timembedded/hyper-fusion-xc/board/3dmodels/WQFN-30-2.5x4.5-p0.4.step

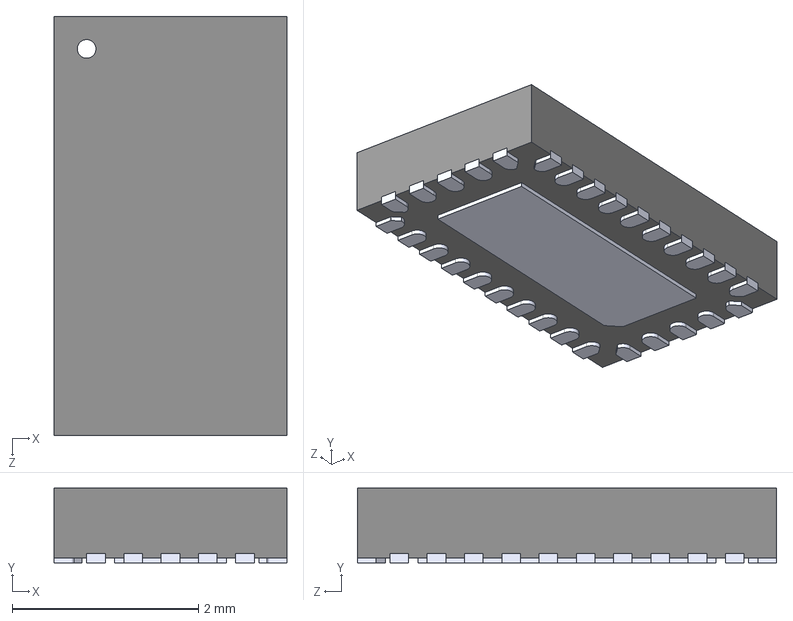
[picture p1: CAD file, 2026-04-17]
board/3dmodels/WQFN-30-2.5x4.5-p0.4.step
2.50 x 0.8 x 4.50 mm
