timembedded/hyper-fusion-xc/board/HyperFusionXC.FCStd

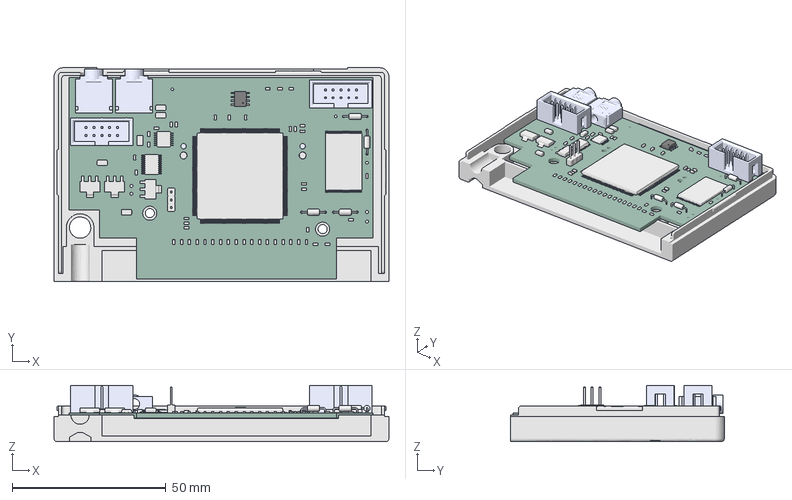
[picture p2: CAD file, 2025-03-14]
board/HyperFusionXC.FCStd
109.0 x 69.5 x 18.3 mm
PinHeader_1x03_P254mm_Vertical
R_0603_1608Metric
R_0603_1608Metric002
R_0603_1608Metric004
D_DO-35_SOD27_P7.62mm_Horizontal
D_DO-35_SOD27_P7.62mm_Horizontal001
R_0603_1608Metric006
C_0603_1608Metric
CP_EIA_3216_10_Kemet_I
R_0603_1608Metric008
R_0603_1608Metric010
R_0603_1608Metric012
R_0603_1608Metric014
CP_EIA_3216_10_Kemet_I001
C_0603_1608Metric002
R_0603_1608Metric016
C_0603_1608Metric004
R_0603_1608Metric018
CP_EIA_3216_10_Kemet_I002
SOT_223
C_0603_1608Metric006
CP_EIA_3216_10_Kemet_I003
LED_0603_1608Metric
C_0603_1608Metric008
TSOP_I_48_184x12mm_P05mm
SOT_224
R_0603_1608Metric020
TSSOP_20_44x65mm_P065mm
R_0603_1608Metric022
R_0603_1608Metric024
R_0603_1608Metric026
R_0603_1608Metric028
R_0603_1608Metric030
C_0603_1608Metric010
R_0603_1608Metric032
R_0603_1608Metric034
CQ assembly
CQ assembly001
CQ assembly002
CQ assembly003
CQ assembly004
CQ assembly005
CQ assembly006
CQ assembly007
CQ assembly008
CQ assembly009
C_0603_1608Metric012
R_0603_1608Metric036
D_DO-35_SOD27_P7.62mm_Horizontal004
D_DO-35_SOD27_P7.62mm_Horizontal005
C_0603_1608Metric014
D_DO-35_SOD27_P7.62mm_Horizontal008
D_DO-35_SOD27_P7.62mm_Horizontal009
TSSOP_14_44x5mm_P065mm
C_0603_1608Metric016
C_0603_1608Metric018
CUI_DEVICES_SJ1-3525N
C_0603_1608Metric020
C_0603_1608Metric022
R_0603_1608Metric038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
