timembedded/hyper-fusion-xc/board/3dmodels/AP7366EA-18W5-7.stp

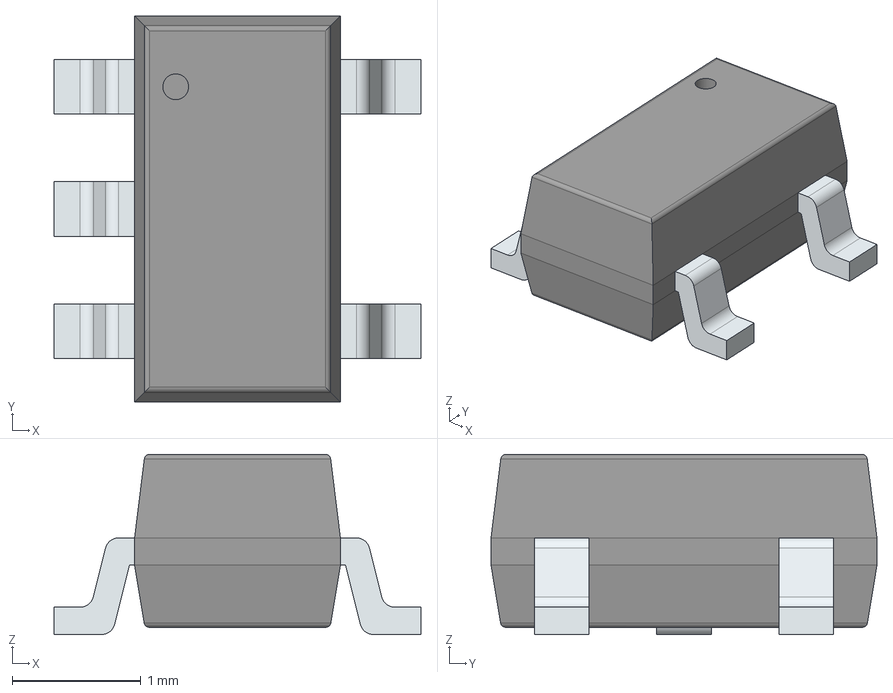
[picture p3: CAD file, 2026-03-26]
board/3dmodels/AP7366EA-18W5-7.stp
2.85 x 3.00 x 1.40 mm
PinsArrayL
PinsArrayR
