timembedded/hyper-fusion-xc/board/3dmodels/DLM0NSN900HY2D.step

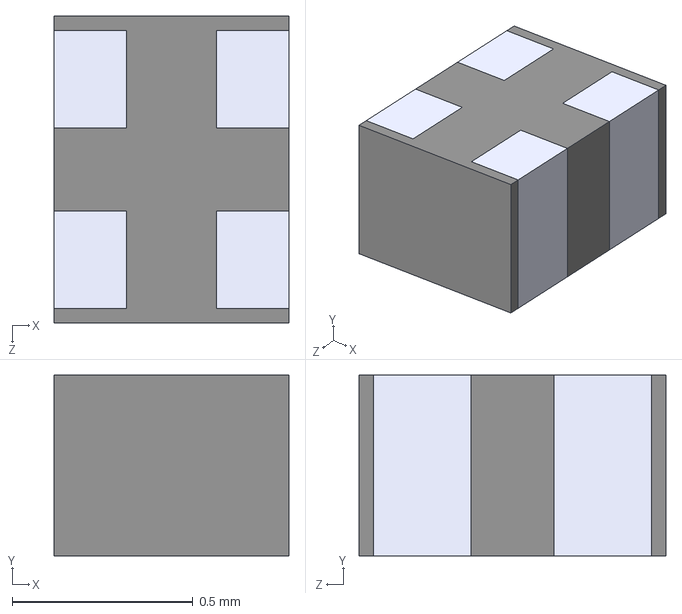
[picture p4: CAD file, 2026-02-20]
board/3dmodels/DLM0NSN900HY2D.step
0.65 x 0.5 x 0.85 mm
