timembedded/hyper-fusion-xc/board/3dmodels/NAU88C22YG.step

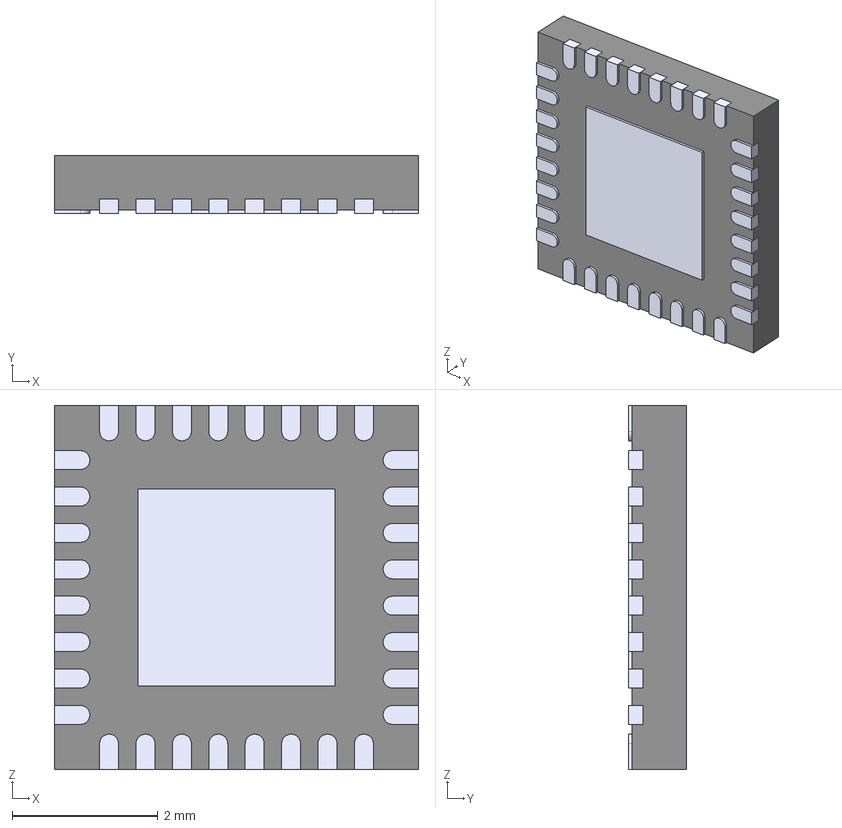
[picture p5: CAD file, 2026-02-02]
board/3dmodels/NAU88C22YG.step
5.00 x 0.8 x 5.00 mm
Body_Solid1
Body001_Solid1
Array_Solid1 x 8
Array001_Solid2 x 7
Body002_Solid1
Array002_Solid1 x 8
Array003_Solid2 x 7
Body003_Solid1
Body004_Solid1
