timembedded/hyper-fusion-xc/board/3dmodels/UJ20-C-H-G-SMT-2-P16-TR.step

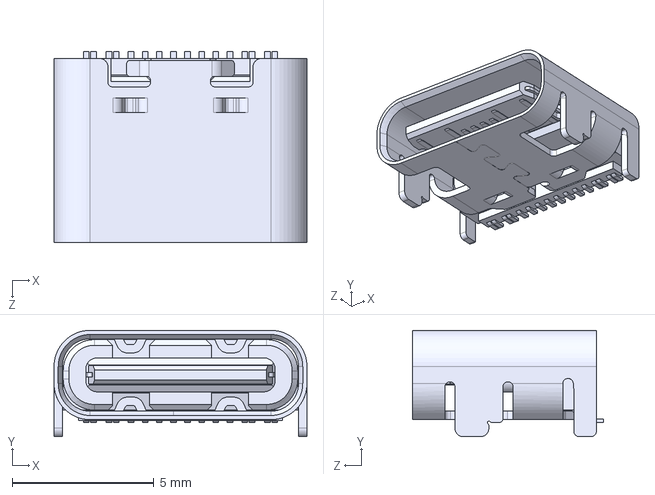
[picture p6: CAD file, 2026-02-02]
board/3dmodels/UJ20-C-H-G-SMT-2-P16-TR.step
8.94 x 3.76 x 6.75 mm
