timembedded/hyper-fusion-xc/board/3dmodels/ESP32-C3-WROOM-02-N4.step

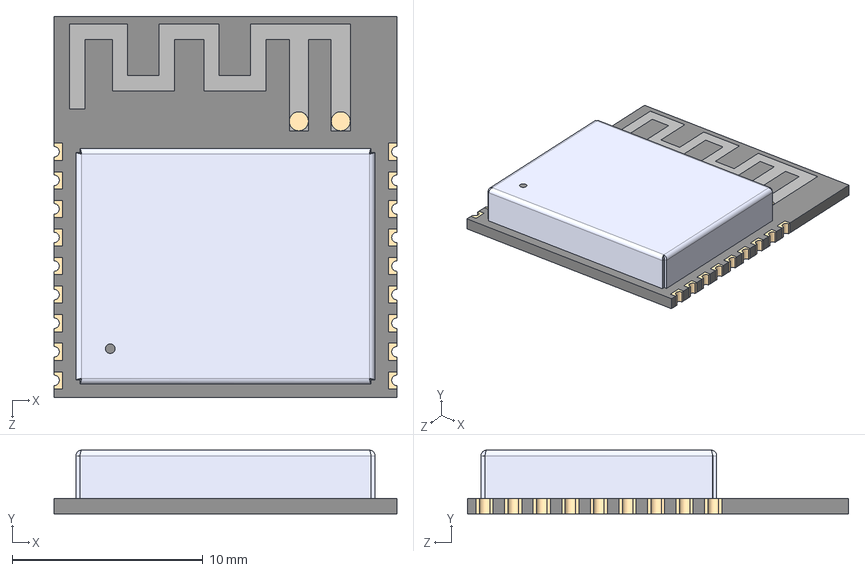
[picture p7: CAD file, 2025-11-15]
board/3dmodels/ESP32-C3-WROOM-02-N4.step
18.0 x 3.35 x 20.0 mm
