timembedded/hyper-fusion-xc/board/3dmodels/SJ-3524-SMT-TR.STEP

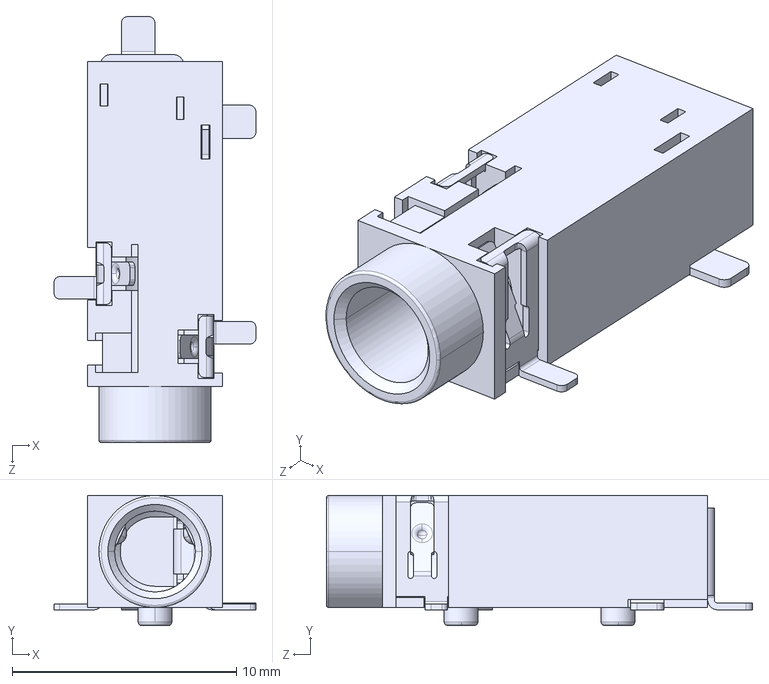
[picture p8: CAD file, 2025-11-15]
board/3dmodels/SJ-3524-SMT-TR.STEP
9.00 x 5.80 x 19.0 mm
