timembedded/hyper-fusion-xc/board/3dmodels/EVQ-P7A01P.step

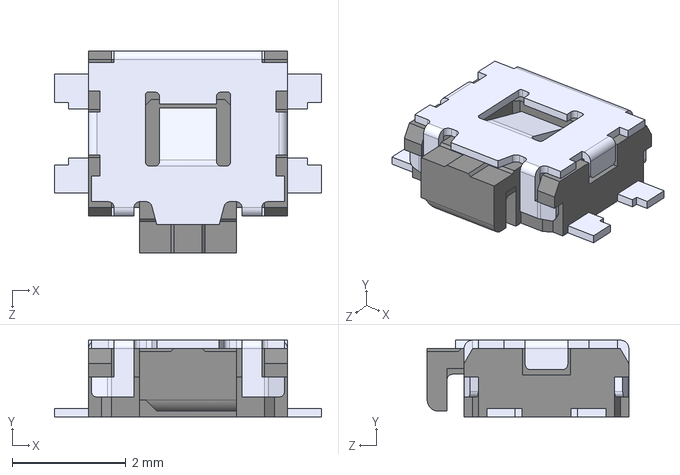
[picture p9: CAD file, 2025-11-15]
board/3dmodels/EVQ-P7A01P.step
4.70 x 1.35 x 3.55 mm
