timembedded/hyper-fusion-xc/board/3dmodels/WNCB-2100037.stp

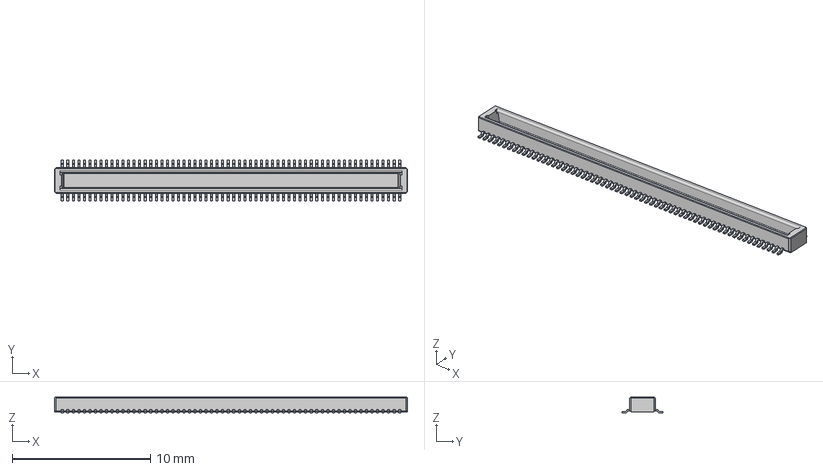
[picture p10: CAD file, 2025-11-15]
board/3dmodels/WNCB-2100037.stp
25.5 x 2.97 x 1.14 mm
