timembedded/hyper-fusion-xc/board/3dmodels/QFP50P700X700X120-32N.step

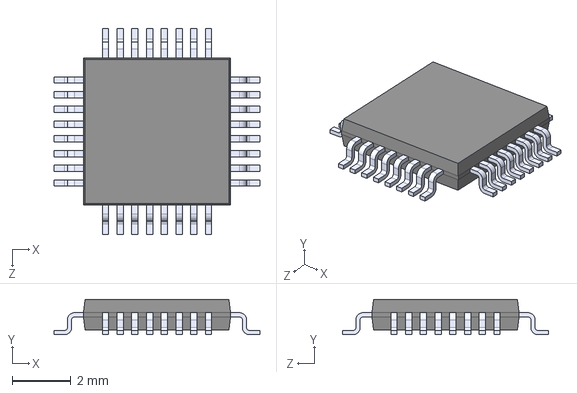
[picture p11: CAD file, 2025-11-15]
board/3dmodels/QFP50P700X700X120-32N.step
7.00 x 1.20 x 7.00 mm
