timembedded/hyper-fusion-xc/board/3dmodels/SS-53000-001.step

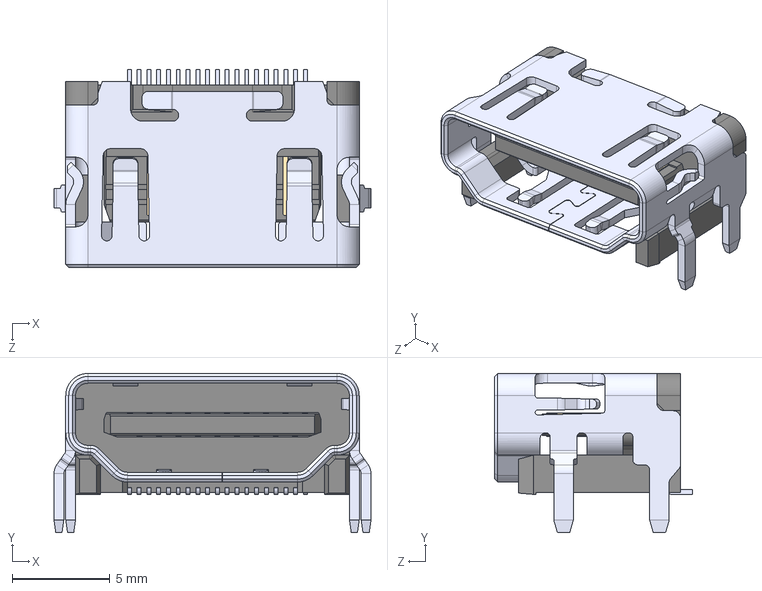
[picture p12: CAD file, 2025-11-15]
board/3dmodels/SS-53000-001.step
16.2 x 8.13 x 10.1 mm
