timembedded/hyper-fusion-xc/board/3dmodels/PTS526SM20SMTR21_LFS.stp

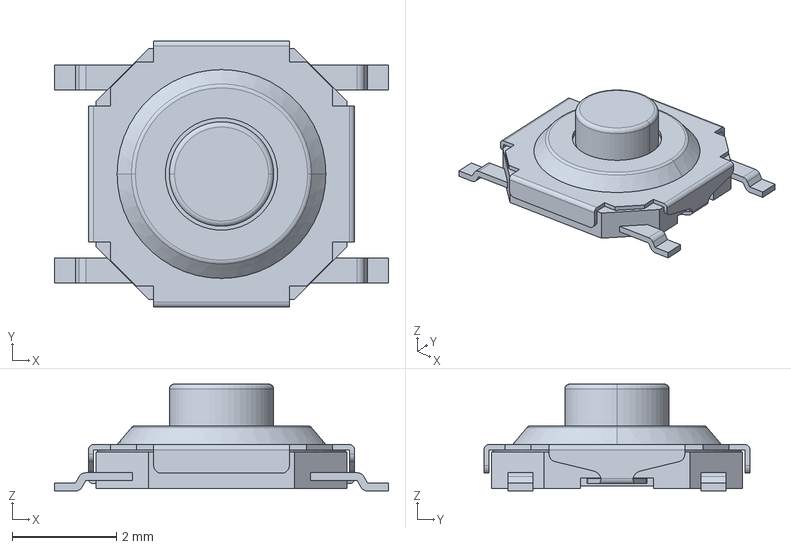
[picture p13: CAD file, 2025-11-15]
board/3dmodels/PTS526SM20SMTR21_LFS.stp
6.40 x 5.10 x 2.05 mm
