timembedded/hyper-fusion-xc/board/3dmodels/TL3336AF160Q.STEP

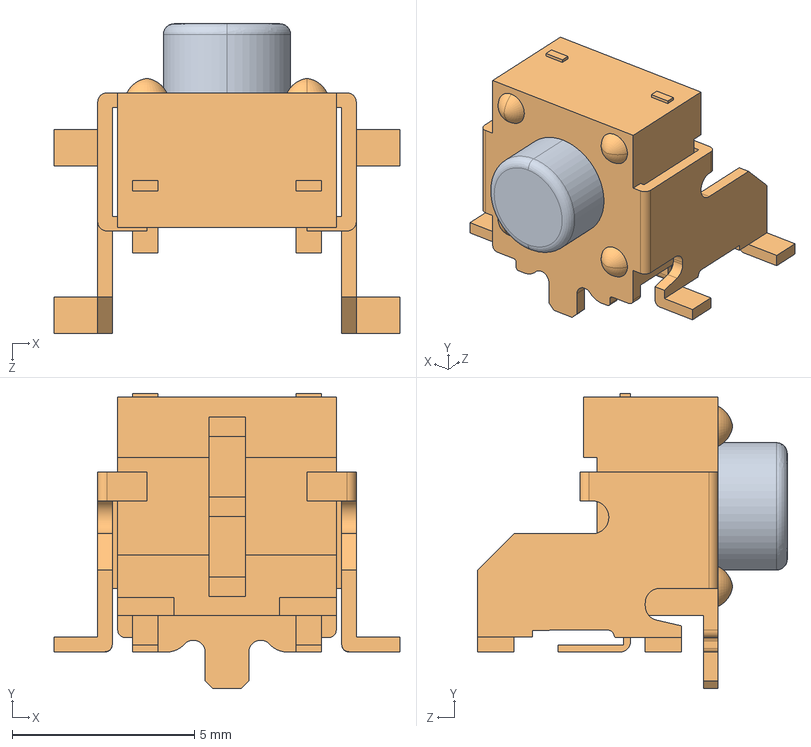
[picture p14: CAD file, 2025-11-15]
board/3dmodels/TL3336AF160Q.STEP
9.50 x 8.10 x 8.50 mm
