timembedded/hyper-fusion-xc/board/3dmodels/CUI_DEVICES_SJ1-3525N.step

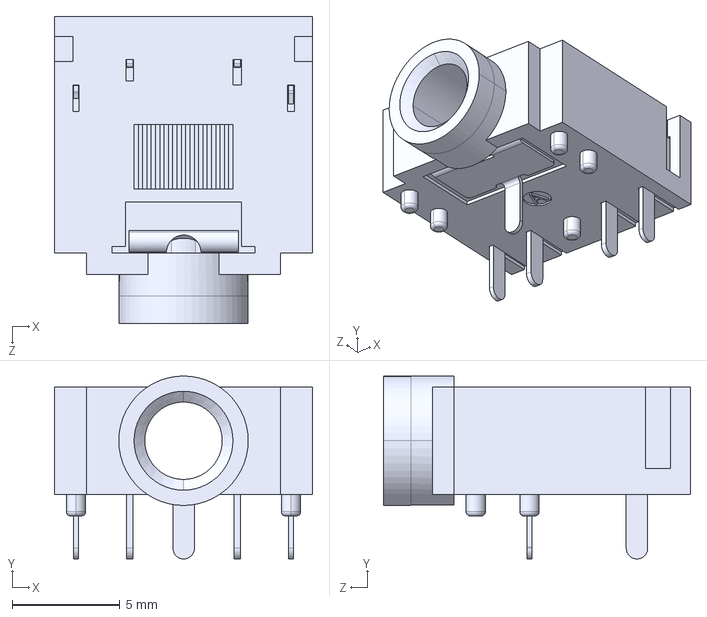
[picture p15: CAD file, 2025-11-15]
board/3dmodels/CUI_DEVICES_SJ1-3525N.step
12.0 x 8.51 x 14.3 mm
