timembedded/hyper-fusion-xc/board/3dmodels/ESP32-S3-WROOM-1-N8R8.STEP

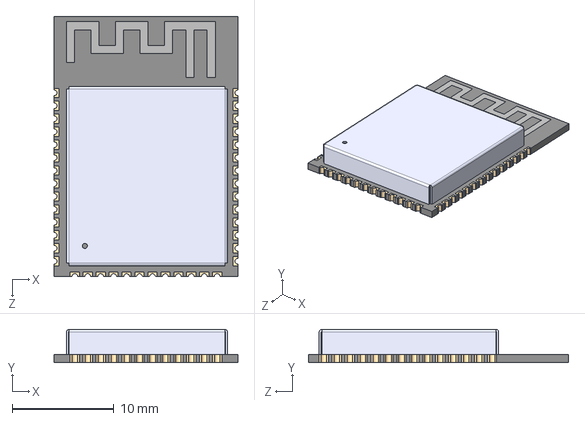
[picture p16: CAD file, 2025-11-15]
board/3dmodels/ESP32-S3-WROOM-1-N8R8.STEP
18.0 x 3.25 x 25.5 mm
