timembedded/hyper-fusion-xc/board/3dmodels/CS1102V6.85F100.stp

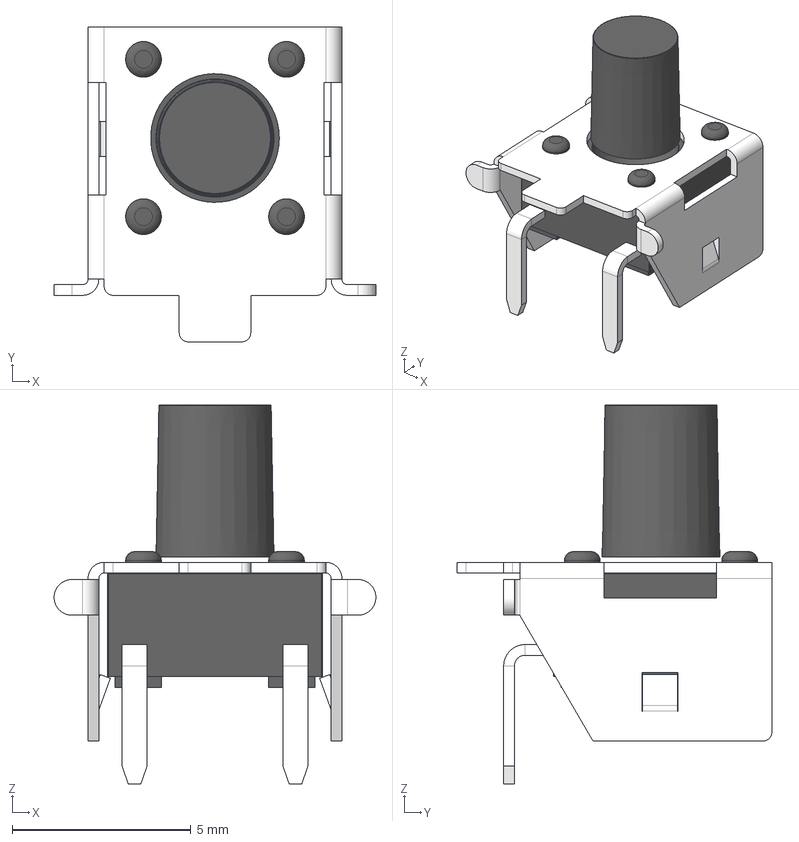
[picture p17: CAD file, 2025-11-15]
board/3dmodels/CS1102V6.85F100.stp
9.00 x 8.80 x 10.6 mm
Base_New
Frame_CS
Terminal x 2
Actuator taper6.85
