timembedded/hyper-fusion-xc/board/3dmodels/2086581201.stp

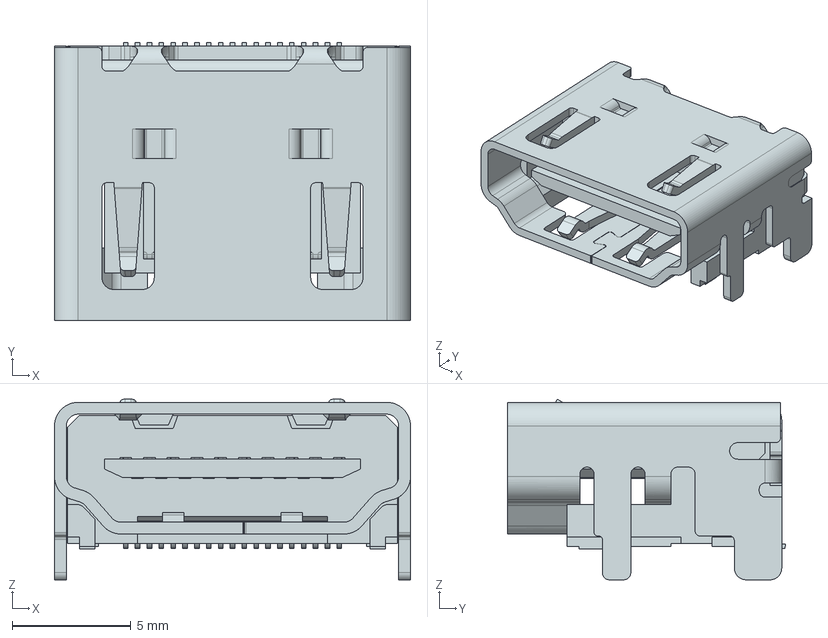
[picture p18: CAD file, 2025-11-15]
board/3dmodels/2086581201.stp
15.0 x 11.7 x 7.61 mm
