timembedded/hyper-fusion-xc/(list of files, cad)

Other CAD files:
board/3dmodels/10029449-111RLF.STEP
board/3dmodels/10067847-001RLF.step
board/3dmodels/467650301.stp
board/3dmodels/9774015151R_20_28rev1_29.stp
