timembedded/hyper-fusion-xc/(list of files, drawings)

Other design files:
board/HyperFusionXC.pcb
