timembedded/hyper-fusion-xc/board/HyperFusionXC.kicad_pcb

## KiCad design board/HyperFusionXC.kicad_pcb (2026-04-17)

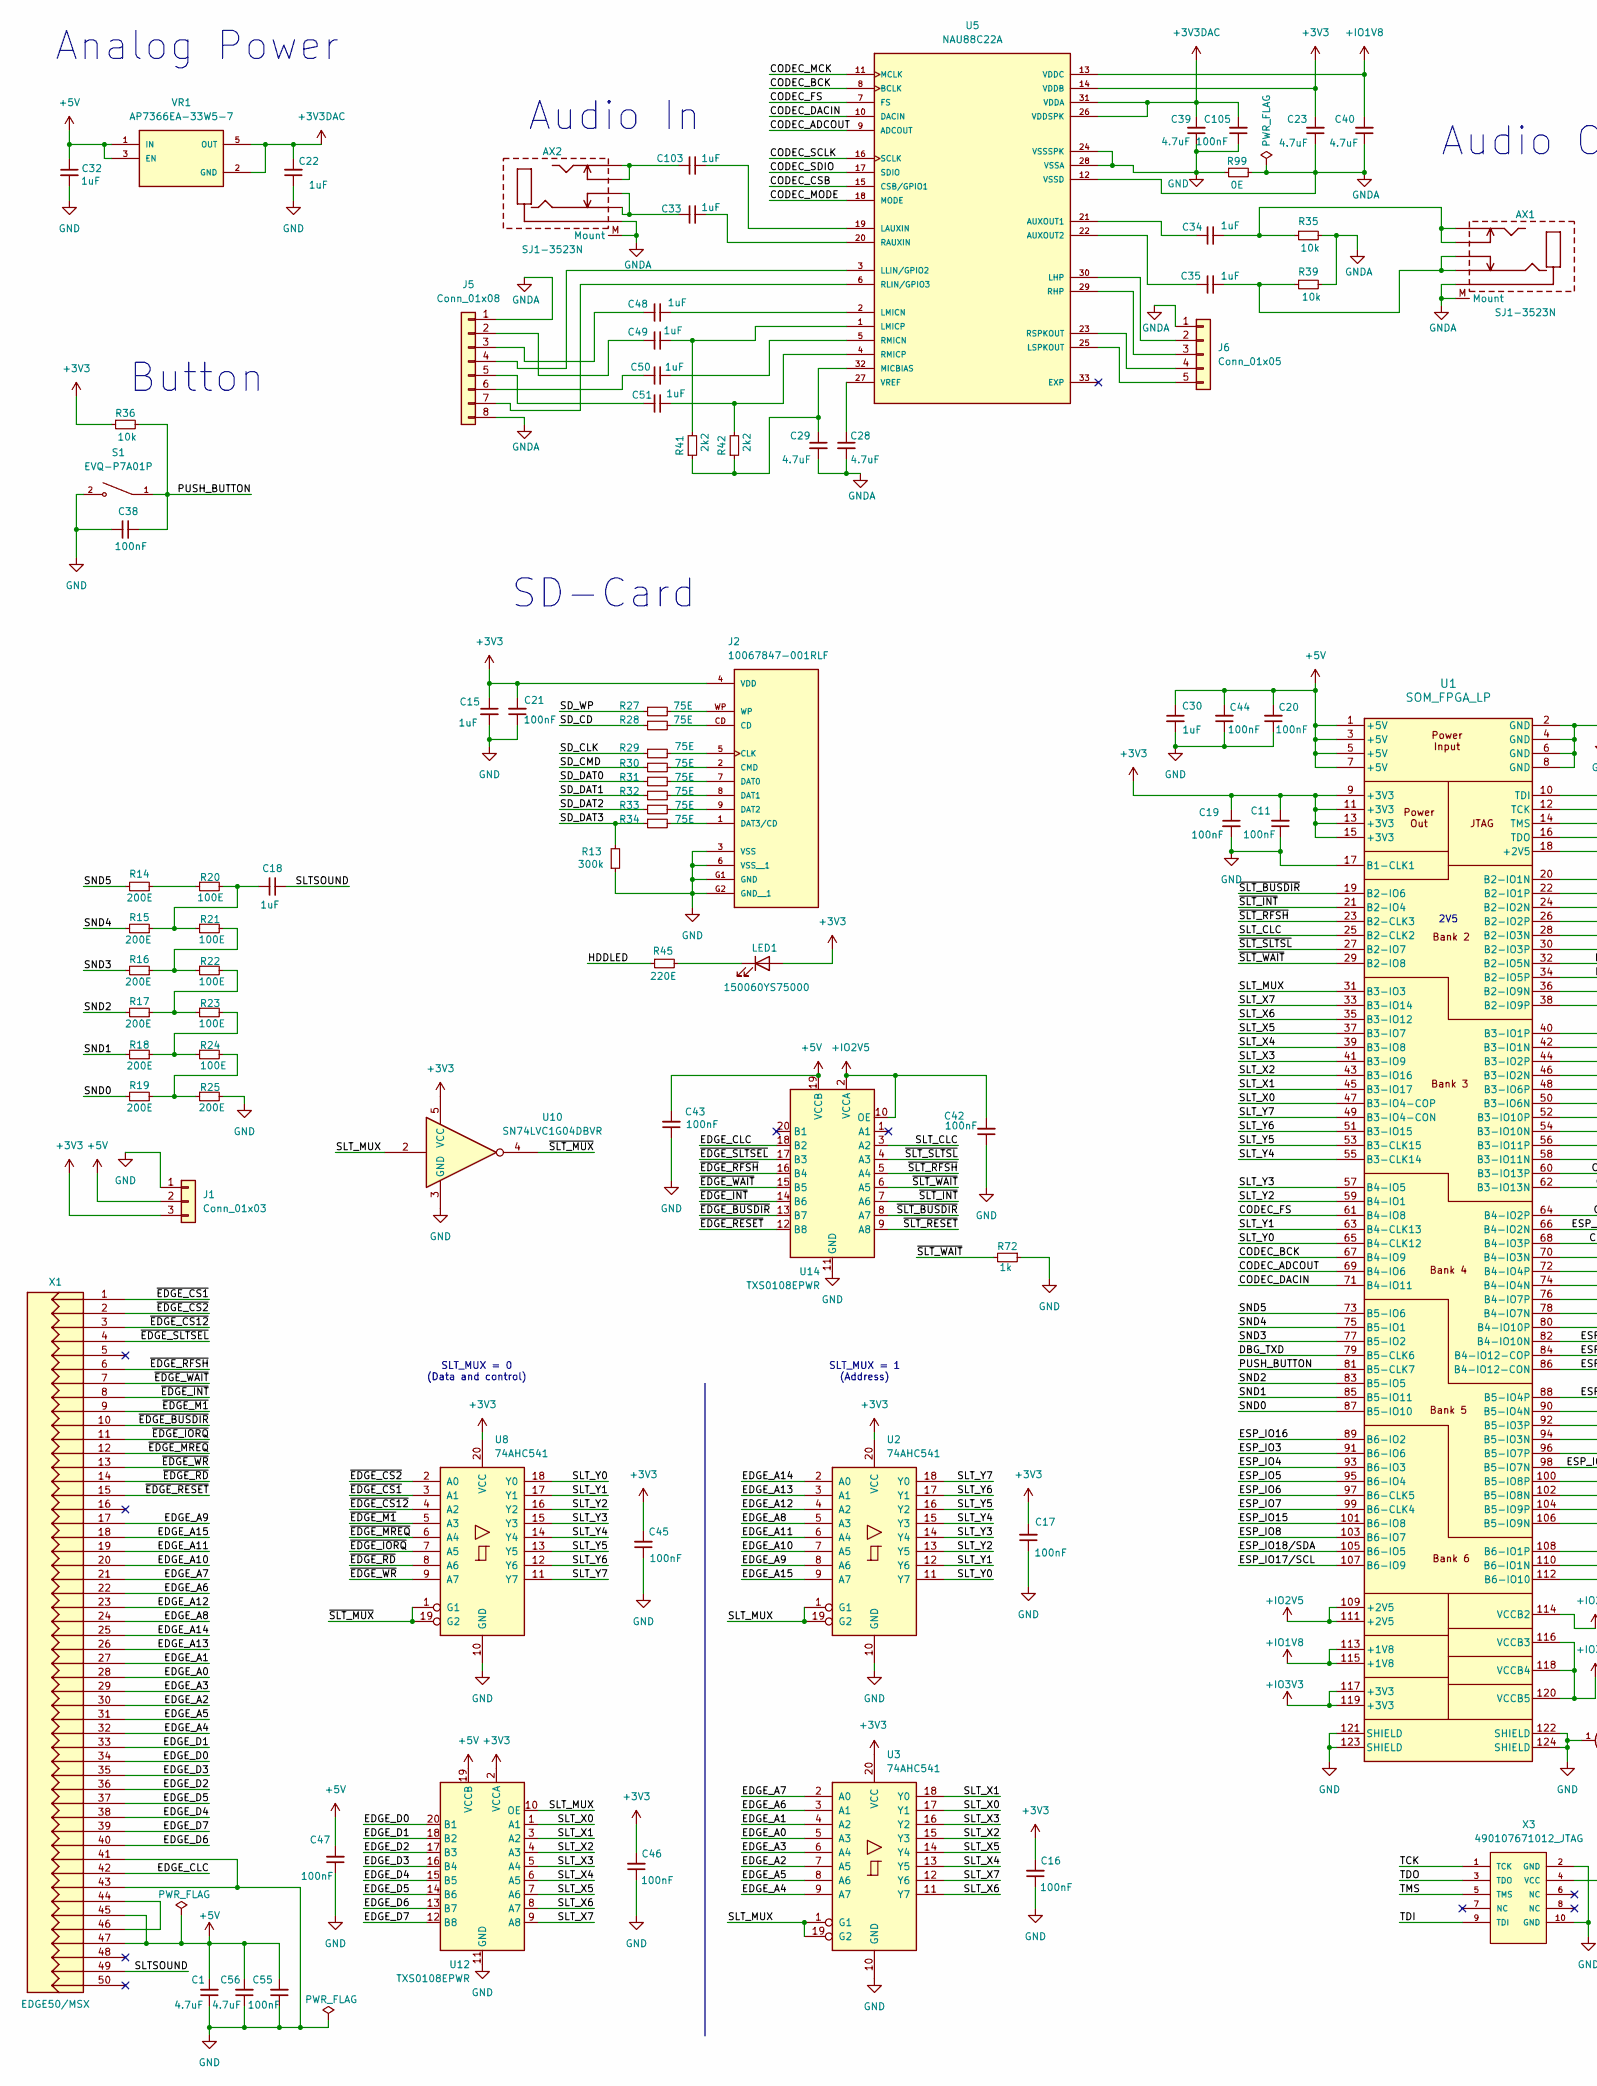
[picture p19: schematic HyperFusionXC.kicad_sch, FusionXC, part in row 1, column 1]

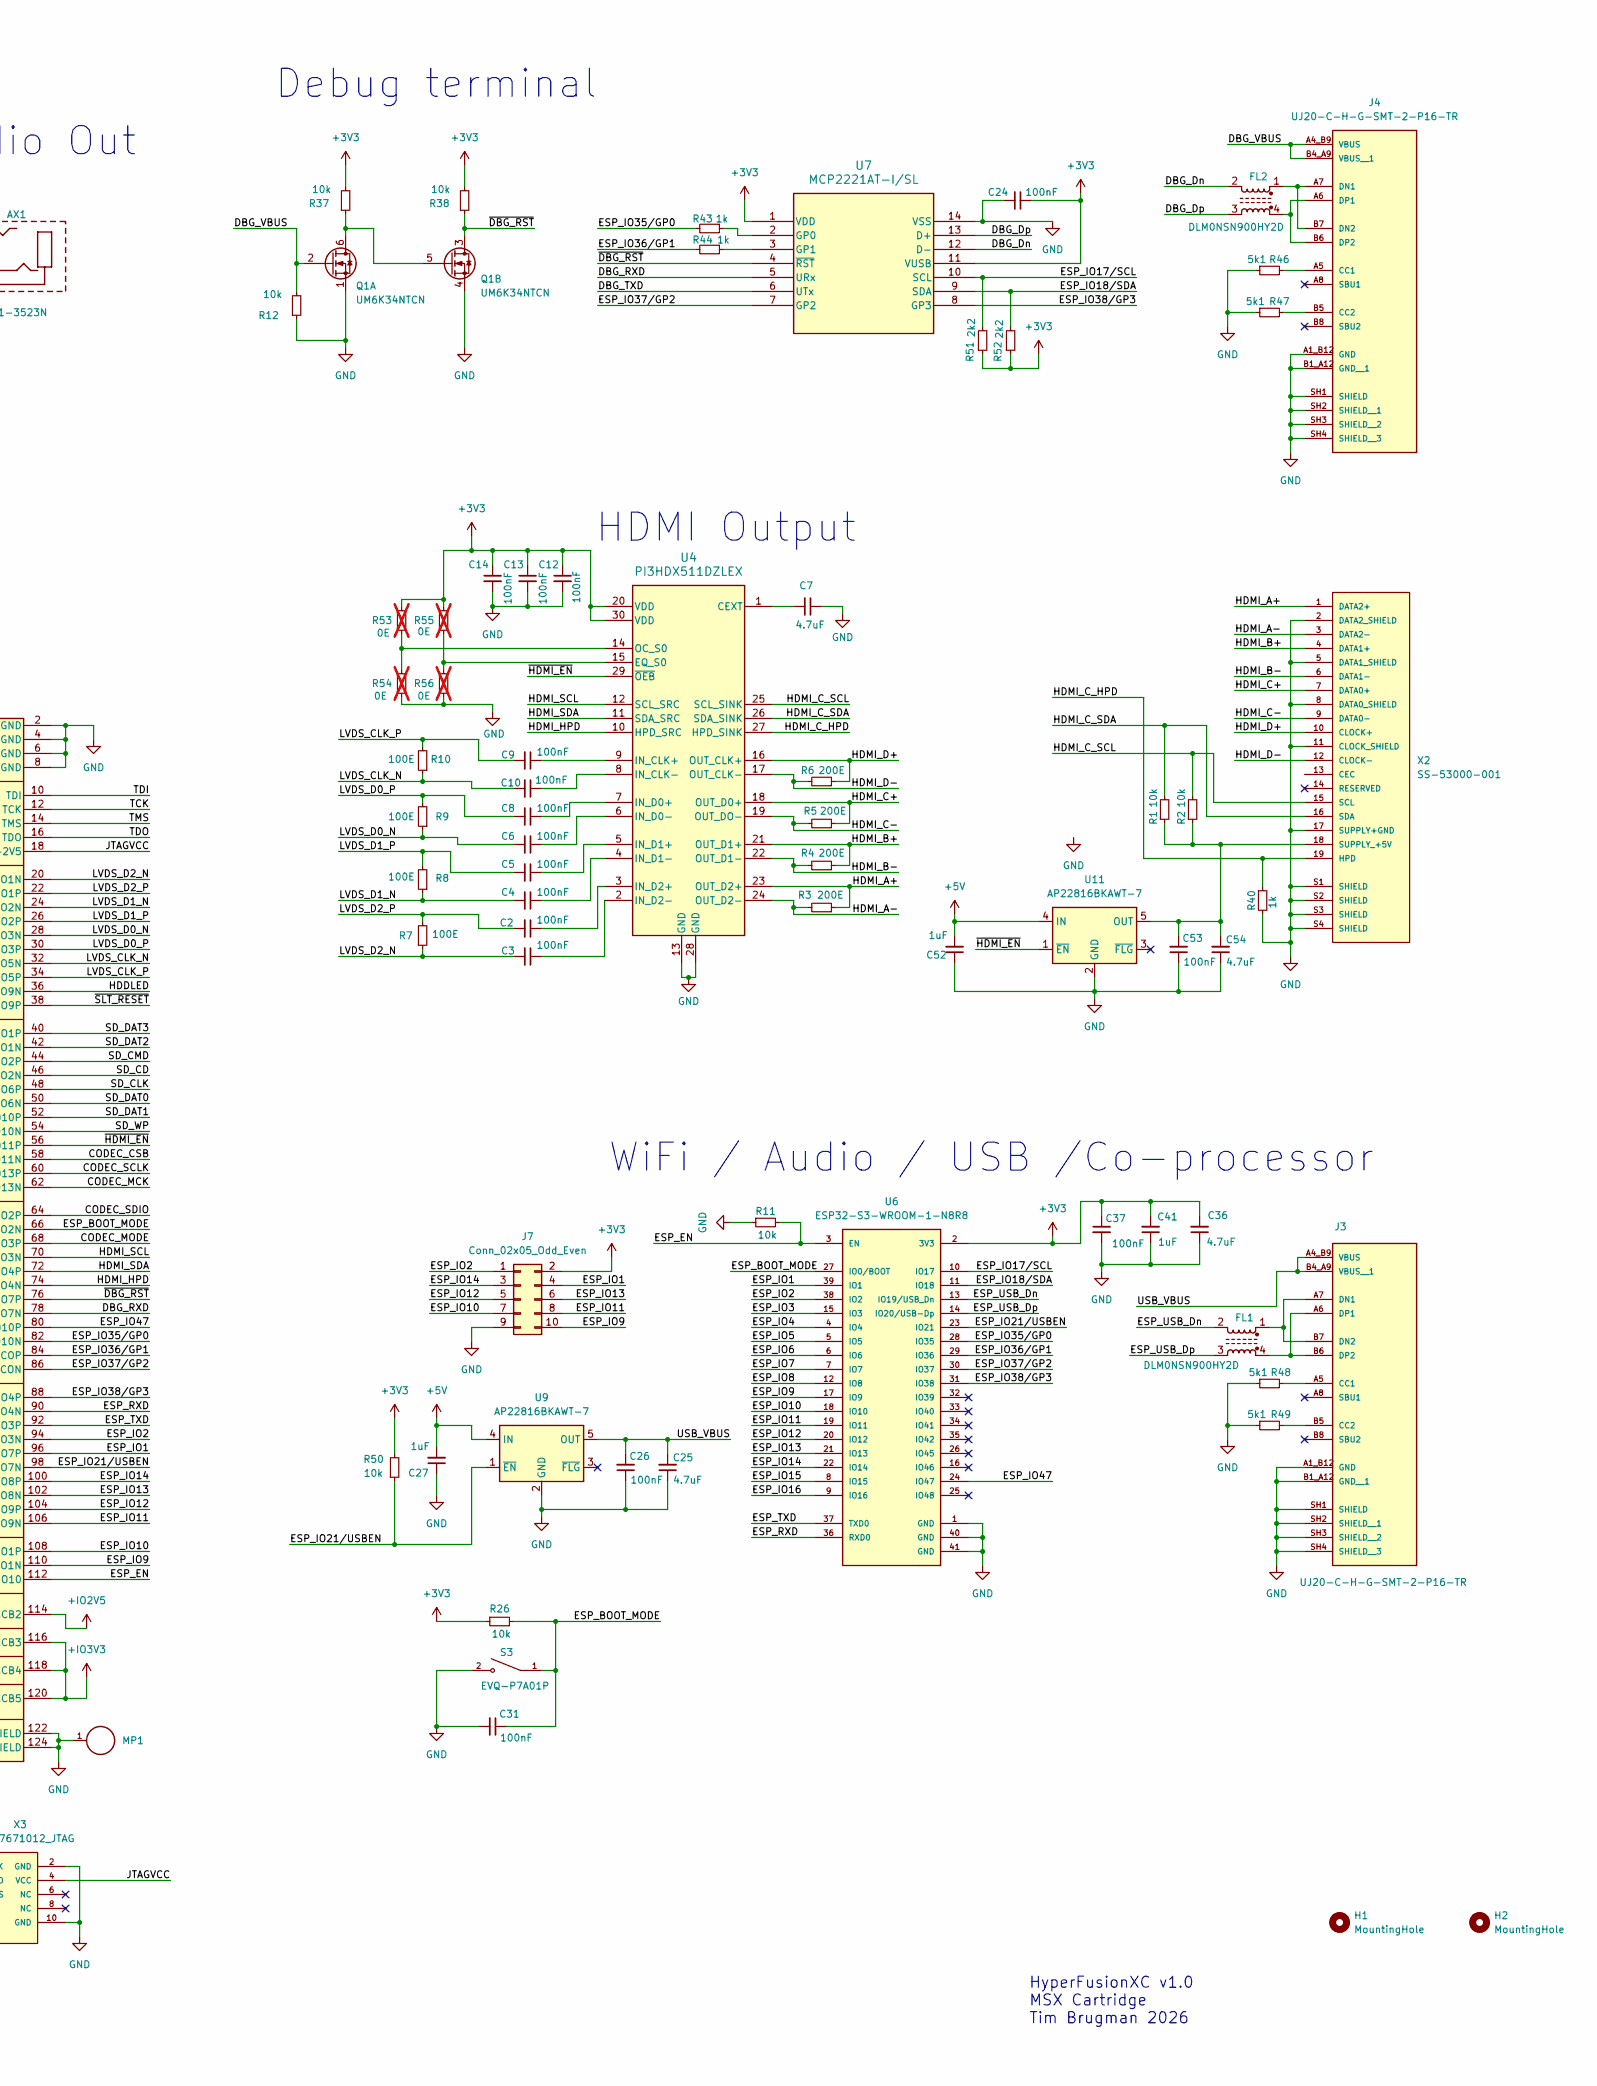
[picture p20: schematic HyperFusionXC.kicad_sch, FusionXC, part in row 1, column 2]

Parts:
AX1, AX2: SJ1-3523N; ST-222_1; DIGIKEY CP1-3523N-ND
C1, C7, C23, C25, C28, C29, C36, C39, C40, C54, C56: 4.7uF; C_0603_1608Metric; DIGIKEY 1276-2087-1-ND
C2, C3, C4, C5, C6, C8, C9, C10, C11, C12, C13, C14, C16, C17, C19, C20, C21, C24, C26, C31, C37, C38, C42, C43, C44, C45, C46, C47, C53, C55, C105: 100nF; C_0603_1608Metric; DIGIKEY 311-1088-1-ND
C15, C18, C22, C27, C30, C32, C33, C34, C35, C41, C48, C49, C50, C51, C52, C103: 1uF; C_0603_1608Metric; DIGIKEY 4988-NMC0603X7R105K6.3TRPFCT-ND
FL1, FL2: DLM0NSN900HY2D; FIL_DLM0NSN900HY2D; DIGIKEY 490-DLM0NSN900HY2DCT-ND
H1, H2: MountingHole
J1: Conn_01x03; PinHeader_1x03_P2.54mm_Vertical
J2: 10067847-001RLF; AMPHENOL_10067847-001RLF; PARTREV K; DIGIKEY 609-3956-1-ND
J3, J4: UJ20-C-H-G-SMT-2-P16-TR; SAMESKY_UJ20-C-H-G-SMT-2-P16-TR; PARTREV 1.0; DIGIKEY 2223-UJ20-C-H-G-SMT-2A-P16-TRCT-ND
J5: Conn_01x08; PinHeader_1x08_P2.00mm_Vertical
J6: Conn_01x05; PinSocket_1x05_P2.00mm_Vertical
J7: Conn_02x05_Odd_Even; PinHeader_2x05_P2.00mm_Vertical
LED1: 150060YS75000; LED_0603_1608Metric_Pad1.05x0.95mm_HandSolder; DIGIKEY 732-4981-1-ND
MP1: M2.5 x 1.5mm; WA-SMSI_9774015151; PART-NUMBER 9774015151R; DIGIKEY 732-7068-1-ND
Q1: UM6K34NTCN; SOT-363_SC-70-6; DIGIKEY UM6K34NTCNCT-ND
R1, R2, R11, R12, R26, R35, R36, R37, R38, R39, R50: 10k; R_0603_1608Metric; DIGIKEY RMCF0603FT10K0CT-ND
R3, R4, R5, R6, R14, R15, R16, R17, R18, R19, R25: 200E; R_0603_1608Metric; DIGIKEY 4463-TFAS0603R2000F-T5CT-ND
R7, R8, R9, R10, R20, R21, R22, R23, R24: 100E; R_0603_1608Metric; DIGIKEY 4463-TFAS0603R1000F-T5CT-ND
R13: 300k; R_0603_1608Metric; DIGIKEY RMCF0603FT300KCT-ND
R27, R28, R29, R30, R31, R32, R33, R34: 75E; R_0603_1608Metric; DIGIKEY RMCF0603FT75R0CT-ND
R40, R43, R44, R72: 1k; R_0603_1608Metric; DIGIKEY RMCF0603FT1K00CT-ND
R41, R42, R51, R52: 2k2; R_0603_1608Metric; DIGIKEY RMCF0603FT2K20CT-ND
R45: 220E; R_0603_1608Metric; DIGIKEY RMCF0603FT220RCT-ND
R46, R47, R48, R49: 5k1; R_0603_1608Metric; DIGIKEY RMCF0603FT5K10CT-ND
R53, R54, R55, R56: 0E; R_0603_1608Metric; DIGIKEY RMCF0603ZT0R00CT-ND; not fitted
R99: 0E; SolderJumper-2_P1.3mm_Bridged_Pad1.0x1.5mm
S1, S3: EVQ-P7A01P; SW_EVQ-P7A01P; PARTREV 2022.4; DIGIKEY P16763CT-ND
U1: SOM_FPGA_LP; DIGIKEY 26-DF40C-120DP-0.4V(51)CT-ND
U2, U3, U8: 74AHC541; TSSOP-20_4.4x6.5mm_P0.65mm; DIGIKEY 1727-3994-1-ND
U4: PI3HDX511DZLEX; Texas_RNH0030A_WQFN-30-1EP_2.5x4.5mm_P0.4mm_EP1.2x3.2mm; DIGIKEY PI3HDX511DZLEXDICT-ND
U5: NAU88C22A; QFN-32-1EP_5x5mm_P0.5mm_EP2.7x2.7mm_ThermalVias; PARTREV 3.3; DIGIKEY NAU88C22YG-ND
U6: ESP32-S3-WROOM-1-N8R8; MODULE_ESP32-S3-WROOM-1-N8R8; DIGIKEY 5407-ESP32-S3-WROOM-1-N8R8CT-ND
U7: MCP2221AT-I/SL; SOIC-14_3.9x8.7mm_P1.27mm; DIGIKEY 150-MCP2221AT-I/SLCT-ND
U9, U11: AP22816BKAWT-7; SOT-23-5; DIGIKEY 31-AP22816BKAWT-7CT-ND
U10: SN74LVC1G04DBVR; SOT-23-5; DIGIKEY 296-11599-1-ND
U12, U14: TXS0108EPWR; TSSOP-20_4.4x6.5mm_P0.65mm; DIGIKEY 296-23011-1-ND
VR1: AP7366EA-33W5-7; SOT-25-AP7366EA; PARTREV 1-2; DIGIKEY 31-AP7366EA-33W5-7CT-ND
X1: EDGE50/MSX; EDGE50_MSX_1
X2: SS-53000-001; STEWART_SS-53000-001; PARTREV A0; DIGIKEY 380-SS-53000-001-ND
X3: 490107671012_JTAG; 490107671012; PARTREV A0; DIGIKEY 732-11636-5-ND

Connections:
+3V3: C11.2, C12.1, C13.1, C14.1, C15.1, C16.2, C17.2, C19.1, C21.2, C23.2, C24.2, C36.2, C37.1, C41.2, C45.2, C46.2, J1.3, J2.4 (VDD), J7.2, LED1.2 (A), R26.1, R36.1, R37.2, R38.2, R50.2, R51.1, R52.1, R53.1, R55.1, U1.9 (+3V3), U1.11 (+3V3), U1.13 (+3V3), U1.15 (+3V3), U2.20 (VCC), U3.20 (VCC), U4.20 (VDD), U4.30 (VDD), U5.14 (VDDB), U6.2 (3V3), U7.1 (VDD), U7.11 (VUSB), U8.20 (VCC), U10.5 (VCC), U12.2 (VCCA)
+3V3DAC: C22.2, C39.2, C105.2, U5.26 (VDDSPK), U5.31 (VDDA), VR1.2 (GND), VR1.5 (OUT)
+5V: C1.2, C20.2, C27.2, C30.1, C32.1, C43.2, C44.2, C47.2, C52.2, C55.2, C56.2, J1.2, U1.1 (+5V), U1.3 (+5V), U1.5 (+5V), U1.7 (+5V), U9.4 (IN), U11.4 (IN), U12.19 (VCCB), U14.19 (VCCB), VR1.1 (IN), VR1.3 (EN), X1.45, X1.47
+IO1V8: C40.2, U1.113 (+1V8), U1.115 (+1V8), U5.13 (VDDC)
+IO2V5: C42.2, U1.109 (+2V5), U1.111 (+2V5), U1.114 (VCCB2), U14.2 (VCCA), U14.10 (OE)
+IO3V3: U1.116 (VCCB3), U1.117 (+3V3), U1.118 (VCCB4), U1.119 (+3V3), U1.120 (VCCB5)
/CODEC_ADCOUT: U1.69 (B4-IO6), U5.9 (ADCOUT)
/CODEC_BCK: U1.67 (B4-IO9), U5.8 (BCLK)
/CODEC_CSB: U1.58 (B3-IO11N), U5.15 (CSB/GPIO1)
/CODEC_DACIN: U1.71 (B4-IO11), U5.10 (DACIN)
/CODEC_FS: U1.61 (B4-IO8), U5.7 (FS)
/CODEC_MCK: U1.62 (B3-IO13N), U5.11 (MCLK)
/CODEC_MODE: U1.68 (B4-IO3P), U5.18 (MODE)
/CODEC_SCLK: U1.60 (B3-IO13P), U5.16 (SCLK)
/CODEC_SDIO: U1.64 (B4-IO2P), U5.17 (SDIO)
/DBG_Dn: FL2.2, U7.12 (D-)
/DBG_Dp: FL2.3, U7.13 (D+)
/DBG_RXD: U1.78 (B4-IO7N), U7.5 (URx)
/DBG_TXD: U1.79 (B5-CLK6), U7.6 (UTx)
/DBG_VBUS: J4.A4_B9 (VBUS), J4.B4_A9 (VBUS__1), Q1.2 (G), R12.2
/EDGE_A0: U3.5 (A3), X1.28
/EDGE_A1: U3.4 (A2), X1.27
/EDGE_A2: U3.7 (A5), X1.30
/EDGE_A3: U3.6 (A4), X1.29
/EDGE_A4: U3.9 (A7), X1.32
/EDGE_A5: U3.8 (A6), X1.31
/EDGE_A6: U3.3 (A1), X1.22
/EDGE_A7: U3.2 (A0), X1.21
/EDGE_A8: U2.5 (A3), X1.24
/EDGE_A9: U2.8 (A6), X1.17
/EDGE_A10: U2.7 (A5), X1.20
/EDGE_A11: U2.6 (A4), X1.19
/EDGE_A12: U2.4 (A2), X1.23
/EDGE_A13: U2.3 (A1), X1.26
/EDGE_A14: U2.2 (A0), X1.25
/EDGE_A15: U2.9 (A7), X1.18
/EDGE_CLC: U14.18 (B2), X1.42
/EDGE_D0: U12.20 (B1), X1.34
/EDGE_D1: U12.18 (B2), X1.33
/EDGE_D2: U12.17 (B3), X1.36
/EDGE_D3: U12.16 (B4), X1.35
/EDGE_D4: U12.15 (B5), X1.38
/EDGE_D5: U12.14 (B6), X1.37
/EDGE_D6: U12.13 (B7), X1.40
/EDGE_D7: U12.12 (B8), X1.39
/ESP_BOOT_MODE: C31.1, R26.2, S3.1, U1.66 (B4-IO2N), U6.27 (IO0/BOOT)
/ESP_EN: R11.2, U1.112 (B6-IO10), U6.3 (EN)
/ESP_IO1: J7.4, U1.96 (B5-IO7P), U6.39 (IO1)
/ESP_IO2: J7.1, U1.94 (B5-IO3N), U6.38 (IO2)
/ESP_IO3: U1.91 (B6-IO6), U6.15 (IO3)
/ESP_IO4: U1.93 (B6-IO3), U6.4 (IO4)
/ESP_IO5: U1.95 (B6-IO4), U6.5 (IO5)
/ESP_IO6: U1.97 (B6-CLK5), U6.6 (IO6)
/ESP_IO7: U1.99 (B6-CLK4), U6.7 (IO7)
/ESP_IO8: U1.103 (B6-IO7), U6.12 (IO8)
/ESP_IO9: J7.10, U1.110 (B6-IO1N), U6.17 (IO9)
/ESP_IO10: J7.7, U1.108 (B6-IO1P), U6.18 (IO10)
/ESP_IO11: J7.8, U1.106 (B5-IO9N), U6.19 (IO11)
/ESP_IO12: J7.5, U1.104 (B5-IO9P), U6.20 (IO12)
/ESP_IO13: J7.6, U1.102 (B5-IO8N), U6.21 (IO13)
/ESP_IO14: J7.3, U1.100 (B5-IO8P), U6.22 (IO14)
/ESP_IO15: U1.101 (B6-IO8), U6.8 (IO15)
/ESP_IO16: U1.89 (B6-IO2), U6.9 (IO16)
/ESP_IO17/SCL: R51.2, U1.107 (B6-IO9), U6.10 (IO17), U7.10 (SCL)
/ESP_IO18/SDA: R52.2, U1.105 (B6-IO5), U6.11 (IO18), U7.9 (SDA)
/ESP_IO21/USBEN: R50.1, U1.98 (B5-IO7N), U6.23 (IO21), U9.1 (~EN)
/ESP_IO35/GP0: R43.2, U1.82 (B4-IO10N), U6.28 (IO35)
/ESP_IO36/GP1: R44.2, U1.84 (B4-IO12-COP), U6.29 (IO36)
/ESP_IO37/GP2: U1.86 (B4-IO12-CON), U6.30 (IO37), U7.7 (GP2)
/ESP_IO38/GP3: U1.88 (B5-IO4P), U6.31 (IO38), U7.8 (GP3)
/ESP_IO47: U1.80 (B4-IO10P), U6.24 (IO47)
/ESP_RXD: U1.90 (B5-IO4N), U6.36 (RXD0)
/ESP_TXD: U1.92 (B5-IO3P), U6.37 (TXD0)
/ESP_USB_Dn: FL1.2, U6.13 (IO19/USB_Dn)
/ESP_USB_Dp: FL1.3, U6.14 (IO20/USB-Dp)
/HDDLED: R45.1, U1.36 (B2-IO9N)
/HDMI_A+: R3.1, U4.23 (OUT_D2+), X2.1 (DATA2+)
/HDMI_A-: R3.2, U4.24 (OUT_D2-), X2.3 (DATA2-)
/HDMI_B+: R4.1, U4.21 (OUT_D1+), X2.4 (DATA1+)
/HDMI_B-: R4.2, U4.22 (OUT_D1-), X2.6 (DATA1-)
/HDMI_C+: R5.1, U4.18 (OUT_D0+), X2.7 (DATA0+)
/HDMI_C-: R5.2, U4.19 (OUT_DO-), X2.9 (DATA0-)
/HDMI_C_HPD: R40.1, U4.27 (HPD_SINK), X2.19 (HPD)
/HDMI_C_SCL: R2.2, U4.25 (SCL_SINK), X2.15 (SCL)
/HDMI_C_SDA: R1.2, U4.26 (SDA_SINK), X2.16 (SDA)
/HDMI_D+: R6.1, U4.16 (OUT_CLK+), X2.10 (CLOCK+)
/HDMI_D-: R6.2, U4.17 (OUT_CLK-), X2.12 (CLOCK-)
/HDMI_HPD: U1.74 (B4-IO4N), U4.10 (HPD_SRC)
/HDMI_SCL: U1.70 (B4-IO3N), U4.12 (SCL_SRC)
/HDMI_SDA: U1.72 (B4-IO4P), U4.11 (SDA_SRC)
/JTAGVCC: U1.18 (+2V5), X3.4 (VCC)
/LVDS_CLK_N: C10.2, R10.1, U1.32 (B2-IO5N)
/LVDS_CLK_P: C9.2, R10.2, U1.34 (B2-IO5P)
/LVDS_D0_N: C6.2, R9.1, U1.28 (B2-IO3N)
/LVDS_D0_P: C8.2, R9.2, U1.30 (B2-IO3P)
/LVDS_D1_N: C4.2, R8.1, U1.24 (B2-IO2N)
/LVDS_D1_P: C5.2, R8.2, U1.26 (B2-IO2P)
/LVDS_D2_N: C3.2, R7.1, U1.20 (B2-IO1N)
/LVDS_D2_P: C2.2, R7.2, U1.22 (B2-IO1P)
/PUSH_BUTTON: C38.1, R36.2, S1.1, U1.81 (B5-CLK7)
/SD_CD: R28.1, U1.46 (B3-IO2N)
/SD_CLK: R29.1, U1.48 (B3-IO6P)
/SD_CMD: R30.1, U1.44 (B3-IO2P)
/SD_DAT0: R31.1, U1.50 (B3-IO6N)
/SD_DAT1: R32.1, U1.52 (B3-IO10P)
/SD_DAT2: R33.1, U1.42 (B3-IO1N)
/SD_DAT3: R13.2, R34.1, U1.40 (B3-IO1P)
/SD_WP: R27.1, U1.54 (B3-IO10N)
/SLTSOUND: C18.1, X1.49
/SLT_CLC: U1.25 (B2-CLK2), U14.3 (A2)
/SLT_MUX: U1.31 (B3-IO3), U2.1 (G1), U2.19 (G2), U3.1 (G1), U3.19 (G2), U10.2, U12.10 (OE)
/SLT_X0: U1.47 (B3-IO4-COP), U3.17 (Y1), U12.1 (A1)
/SLT_X1: U1.45 (B3-IO17), U3.18 (Y0), U12.3 (A2)
/SLT_X2: U1.43 (B3-IO16), U3.15 (Y3), U12.4 (A3)
/SLT_X3: U1.41 (B3-IO9), U3.16 (Y2), U12.5 (A4)
/SLT_X4: U1.39 (B3-IO8), U3.13 (Y5), U12.6 (A5)
/SLT_X5: U1.37 (B3-IO7), U3.14 (Y4), U12.7 (A6)
/SLT_X6: U1.35 (B3-IO12), U3.11 (Y7), U12.8 (A7)
/SLT_X7: U1.33 (B3-IO14), U3.12 (Y6), U12.9 (A8)
/SLT_Y0: U1.65 (B4-CLK12), U2.11 (Y7), U8.18 (Y0)
/SLT_Y1: U1.63 (B4-CLK13), U2.12 (Y6), U8.17 (Y1)
/SLT_Y2: U1.59 (B4-IO1), U2.13 (Y5), U8.16 (Y2)
/SLT_Y3: U1.57 (B4-IO5), U2.14 (Y4), U8.15 (Y3)
/SLT_Y4: U1.55 (B3-CLK14), U2.15 (Y3), U8.14 (Y4)
/SLT_Y5: U1.53 (B3-CLK15), U2.16 (Y2), U8.13 (Y5)
/SLT_Y6: U1.51 (B3-IO15), U2.17 (Y1), U8.12 (Y6)
/SLT_Y7: U1.49 (B3-IO4-CON), U2.18 (Y0), U8.11 (Y7)
/SND0: R19.2, U1.87 (B5-IO10)
/SND1: R18.2, U1.85 (B5-IO11)
/SND2: R17.2, U1.83 (B5-IO5)
/SND3: R16.2, U1.77 (B5-IO2)
/SND4: R15.2, U1.75 (B5-IO1)
/SND5: R14.2, U1.73 (B5-IO6)
/TCK: U1.12 (TCK), X3.1 (TCK)
/TDI: U1.10 (TDI), X3.9 (TDI)
/TDO: U1.16 (TDO), X3.3 (TDO)
/TMS: U1.14 (TMS), X3.5 (TMS)
/USB_VBUS: C25.2, C26.2, J3.A4_B9 (VBUS), J3.B4_A9 (VBUS__1), U9.5 (OUT)
/~DBG_RST: Q1.3 (D), R38.1, U1.76 (B4-IO7P), U7.4 (~RST)
/~EDGE_BUSDIR: U14.13 (B7), X1.10
/~EDGE_CS1: U8.3 (A1), X1.1
/~EDGE_CS2: U8.2 (A0), X1.2
/~EDGE_CS12: U8.4 (A2), X1.3
/~EDGE_INT: U14.14 (B6), X1.8
/~EDGE_IORQ: U8.7 (A5), X1.11
/~EDGE_M1: U8.5 (A3), X1.9
/~EDGE_MREQ: U8.6 (A4), X1.12
/~EDGE_RD: U8.8 (A6), X1.14
/~EDGE_RESET: U14.12 (B8), X1.15
/~EDGE_RFSH: U14.16 (B4), X1.6
/~EDGE_SLTSEL: U14.17 (B3), X1.4
/~EDGE_WAIT: U14.15 (B5), X1.7
/~EDGE_WR: U8.9 (A7), X1.13
/~HDMI_EN: U1.56 (B3-IO11P), U4.29 (~OEB), U11.1 (~EN)
/~SLT_BUSDIR: U1.19 (B2-IO6), U14.8 (A7)
/~SLT_INT: U1.21 (B2-IO4), U14.7 (A6)
/~SLT_MUX: U8.1 (G1), U8.19 (G2), U10.4
/~SLT_RESET: U1.38 (B2-IO9P), U14.9 (A8)
/~SLT_RFSH: U1.23 (B2-CLK3), U14.5 (A4)
/~SLT_SLTSL: U1.27 (B2-IO7), U14.4 (A3)
/~SLT_WAIT: R72.2, U1.29 (B2-IO8), U14.6 (A5)
GND: C1.1, C7.1, C11.1, C12.2, C13.2, C14.2, C15.2, C16.1, C17.1, C19.2, C20.1, C21.1, C22.1, C24.1, C25.1, C26.1, C27.1, C30.2, C31.2, C32.2, C36.1, C37.2, C38.2, C39.1, C41.1, C42.1, C43.1, C44.1, C45.1, C46.1, C47.1, C52.1, C53.1, C54.1, C55.1, C56.1, C105.1, J1.1, J2.3 (VSS), J2.6 (VSS__1), J2.G1 (GND), J2.G2 (GND__1), J3.A1_B12 (GND), J3.B1_A12 (GND__1), J3.SH1 (SHIELD), J3.SH2 (SHIELD__1), J3.SH3 (SHIELD__2), J3.SH4 (SHIELD__3), J4.A1_B12 (GND), J4.B1_A12 (GND__1), J4.SH1 (SHIELD), J4.SH2 (SHIELD__1), J4.SH3 (SHIELD__2), J4.SH4 (SHIELD__3), J7.9, MP1.1, Q1.1 (S), Q1.4 (S), R11.1, R12.1, R13.1, R25.2, R40.2, R46.1, R47.1, R48.1, R49.1, R54.2, R56.2, R72.1, R99.1, S1.2, S3.2, U1.2 (GND), U1.4 (GND), U1.6 (GND), U1.8 (GND), U1.17 (B1-CLK1), U1.121 (SHIELD), U1.122 (SHIELD), U1.123 (SHIELD), U1.124 (SHIELD), U2.10 (GND), U3.10 (GND), U4.13 (GND), U4.28 (GND), U5.24 (VSSSPK), U5.28 (VSSA), U6.1 (GND), U6.40 (GND), U6.41 (GND), U7.14 (VSS), U8.10 (GND), U9.2 (GND), U10.3 (GND), U11.2 (GND), U12.11 (GND), U14.11 (GND), X1.41, X1.43, X2.2 (DATA2_SHIELD), X2.5 (DATA1_SHIELD), X2.8 (DATA0_SHIELD), X2.11 (CLOCK_SHIELD), X2.17 (SUPPLY+GND), X2.S1 (SHIELD), X2.S2 (SHIELD), X2.S3 (SHIELD), X2.S4 (SHIELD), X3.2 (GND), X3.10 (GND)
GNDA: AX1.1, AX1.M (Mount), AX2.1, AX2.M (Mount), C23.1, C28.2, C29.2, C40.1, J5.1, J5.8, J6.1, R35.2, R39.2, R99.2, U5.12 (VSSD)
unnamed: AX1.2, AX1.3, C35.1, R39.1
unnamed: AX1.4, AX1.5, C34.1, R35.1
unnamed: AX2.2, AX2.3, C33.2
unnamed: AX2.4, AX2.5, C103.2
unnamed: C18.2, R15.1, R20.2, R21.1
unnamed: J2.5 (CLK), R29.2
unnamed: J2.2 (CMD), R30.2
unnamed: J2.7 (DAT0), R31.2
unnamed: J2.8 (DAT1), R32.2
unnamed: J2.9 (DAT2), R33.2
unnamed: J2.1 (DAT3/CD), R34.2
unnamed: J2.CD, R28.2
unnamed: J2.WP, R27.2
unnamed: J3.A5 (CC1), R48.2
unnamed: J3.B5 (CC2), R49.2
unnamed: FL1.1, J3.A7 (DN1), J3.B7 (DN2)
unnamed: FL1.4, J3.A6 (DP1), J3.B6 (DP2)
unnamed: J4.A5 (CC1), R46.2
unnamed: J4.B5 (CC2), R47.2
unnamed: FL2.1, J4.A7 (DN1), J4.B7 (DN2)
unnamed: FL2.4, J4.A6 (DP1), J4.B6 (DP2)
unnamed: C49.2, J5.2
unnamed: C48.2, J5.3
unnamed: J5.4, U5.3 (LLIN/GPIO2)
unnamed: C51.2, J5.5
unnamed: C50.2, J5.6
unnamed: J5.7, U5.6 (RLIN/GPIO3)
unnamed: J6.2, U5.30 (LHP)
unnamed: J6.3, U5.29 (RHP)
unnamed: J6.4, U5.23 (RSPKOUT)
unnamed: J6.5, U5.25 (LSPKOUT)
unnamed: LED1.1 (K), R45.2
unnamed: Q1.5 (G), Q1.6 (D), R37.1
unnamed: R14.1, R20.1
unnamed: R16.1, R21.2, R22.1
unnamed: R17.1, R22.2, R23.1
unnamed: R18.1, R23.2, R24.1
unnamed: R19.1, R24.2, R25.1
unnamed: C7.2, U4.1 (CEXT)
unnamed: R55.2, R56.1, U4.15 (EQ_S0)
unnamed: C9.1, U4.9 (IN_CLK+)
unnamed: C10.1, U4.8 (IN_CLK-)
unnamed: C8.1, U4.7 (IN_D0+)
unnamed: C6.1, U4.6 (IN_D0-)
unnamed: C5.1, U4.5 (IN_D1+)
unnamed: C4.1, U4.4 (IN_D1-)
unnamed: C2.1, U4.3 (IN_D2+)
unnamed: C3.1, U4.2 (IN_D2-)
unnamed: R53.2, R54.1, U4.14 (OC_S0)
unnamed: C34.2, U5.21 (AUXOUT1)
unnamed: C35.2, U5.22 (AUXOUT2)
unnamed: C103.1, U5.19 (LAUXIN)
unnamed: C48.1, U5.2 (LMICN)
unnamed: C49.1, R41.2, U5.1 (LMICP)
unnamed: C29.1, R41.1, R42.1, U5.32 (MICBIAS)
unnamed: C33.1, U5.20 (RAUXIN)
unnamed: C50.1, U5.5 (RMICN)
unnamed: C51.1, R42.2, U5.4 (RMICP)
unnamed: C28.1, U5.27 (VREF)
unnamed: R43.1, U7.2 (GP0)
unnamed: R44.1, U7.3 (GP1)
unnamed: C53.2, C54.2, R1.1, R2.1, U11.5 (OUT), X2.18 (SUPPLY_+5V)
unnamed: X1.44, X1.46

Notes on the sheet:
WiFi / Audio / USB /Co-processor
Debug terminal
SD-Card
HDMI Output
Analog Power
SLT_MUX = 0 (Data and control)
SLT_MUX = 1 (Address)
Audio In
Audio Out
Button
2V5
HyperFusionXC v1.0 MSX Cartridge Tim Brugman 2026

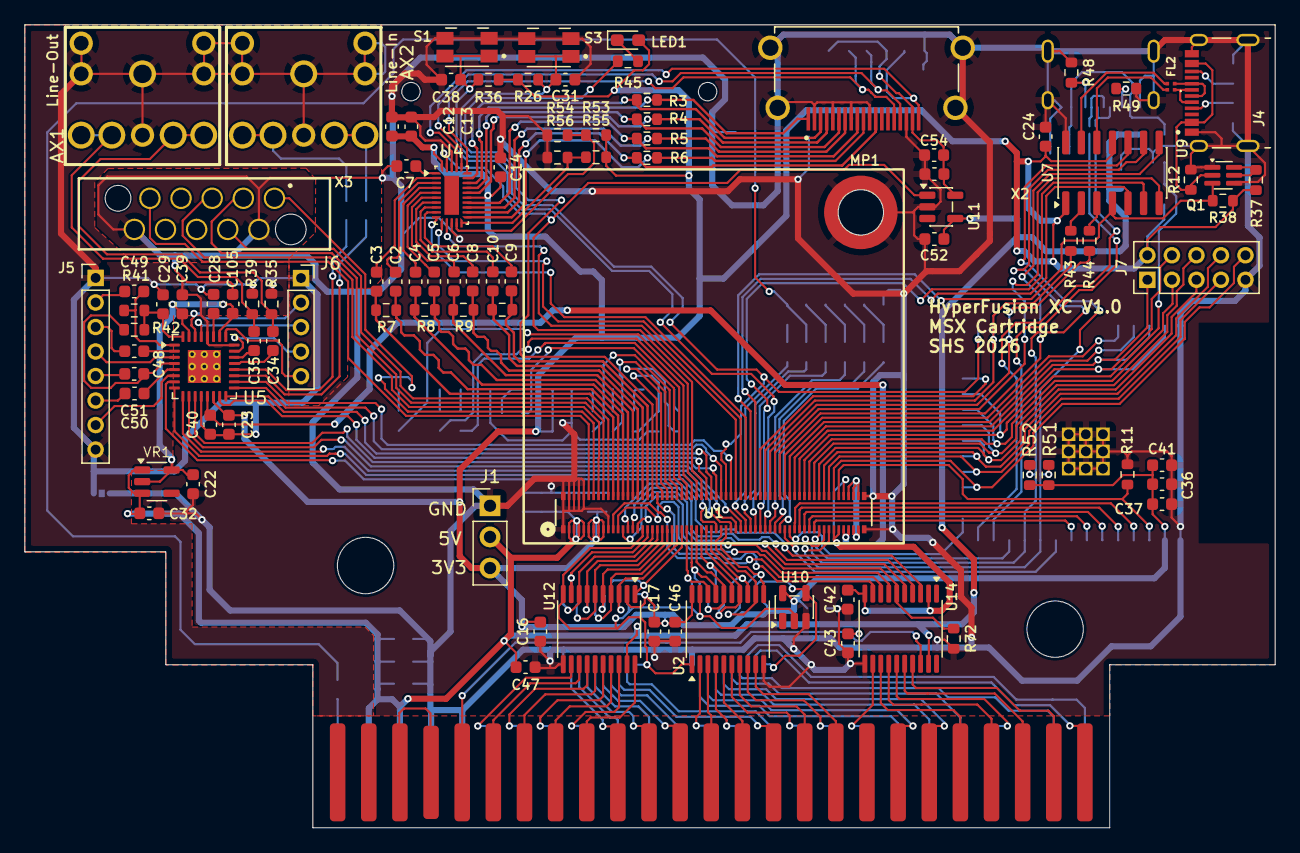
[picture p21: board HyperFusionXC.kicad_pcb from above]

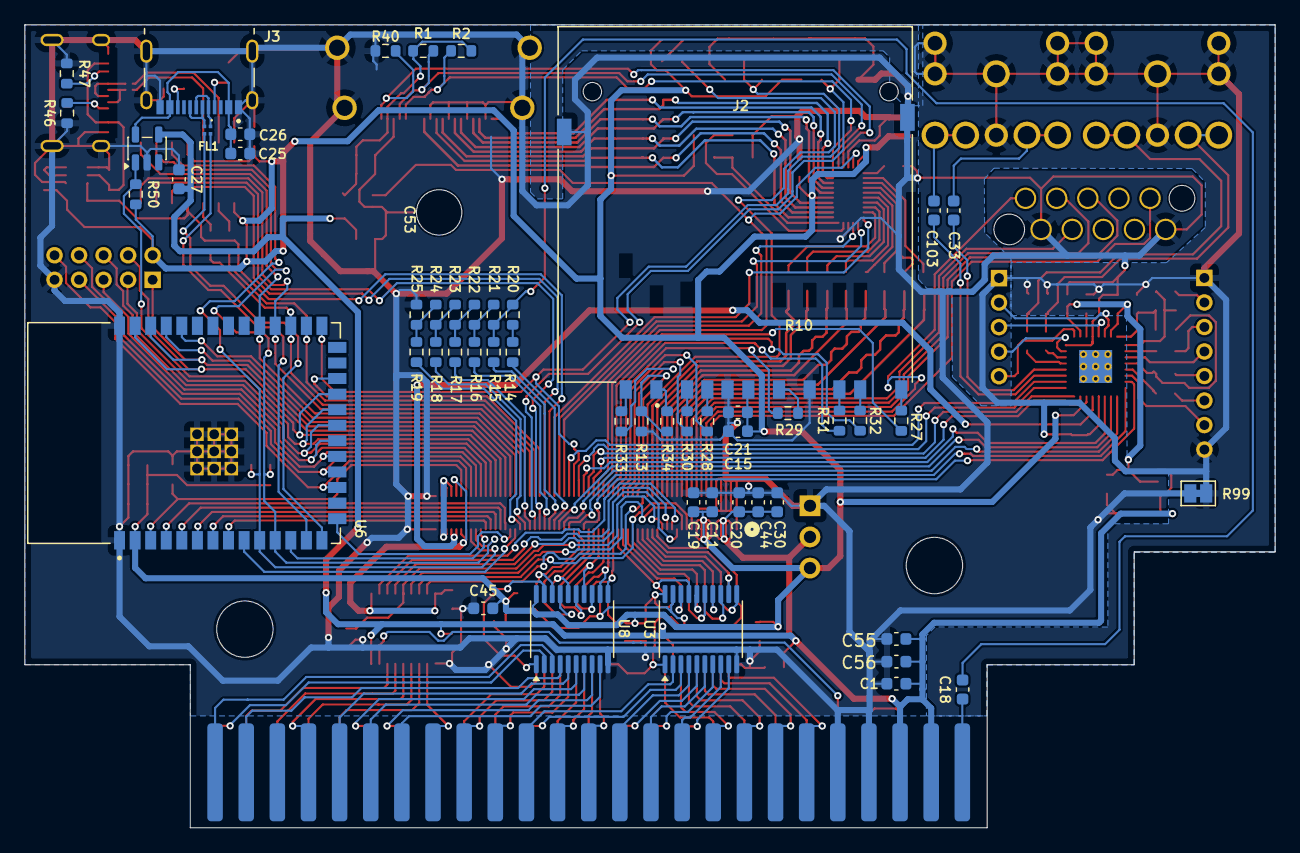
[picture p22: board HyperFusionXC.kicad_pcb from below]

Board: 2 copper layers, 102.0 x 65.5 mm, 151 parts (52 on the bottom side), 226 nets.
