timembedded/hyper-fusion-xc/firmware/esp32s3/main/bluemsx/OpenMsxYM2413_2.h

// This file is taken from the openMSX project. 
// The file has been modified to be built in the blueMSX environment.

#ifndef __YM2413_2_HH__
#define __YM2413_2_HH__

#include <string>

using namespace std;


typedef unsigned long  EmuTime;
typedef unsigned char  uint8_t;
typedef unsigned short word;

extern "C" {
#include "AudioMixer.h"
}


#ifndef OPENMSX_SOUNDDEVICE
#define OPENMSX_SOUNDDEVICE

class SoundDevice
{
    public:
        SoundDevice() : internalMuted(true) {}
        void setVolume(short newVolume) {
            setInternalVolume(newVolume);
        }

    protected:
        virtual void setInternalVolume(short newVolume) = 0;
        void setInternalMute(bool muted) { internalMuted = muted; }
    public:
        bool isInternalMuted() const { return internalMuted; }
        virtual void setSampleRate(int newSampleRate, int Oversampling) = 0;
        virtual int* updateBuffer(int *buffer, int length) = 0;

    private:
        bool internalMuted;
};

#endif

#ifndef OPENMSX_YM2413BASE
#define OPENMSX_YM2413BASE

class OpenYM2413Base : public SoundDevice
{
public:
    OpenYM2413Base() {}
    virtual ~OpenYM2413Base() {}
        
    virtual void reset() = 0;
    virtual void writeReg(uint8_t r, uint8_t v) = 0;
    virtual uint8_t peekReg(uint8_t r) = 0;
    
    virtual int* updateBuffer(int *buffer, int length) = 0;
    virtual void setSampleRate(int sampleRate, int Oversampling) = 0;
    virtual void setInternalVolume(short newVolume) = 0;
};

#endif

// Size of Sintable ( 8 -- 18 can be used, but 9 recommended.)
static const int PG_BITS = 9;
static const int PG_WIDTH = 1 << PG_BITS;

// Phase increment counter
static const int DP_BITS = 18;
static const int DP_WIDTH = 1 << DP_BITS;
static const int DP_BASE_BITS = DP_BITS - PG_BITS;

// Dynamic range (Accuracy of sin table)
static const int DB_BITS = 8;
static const double DB_STEP = 48.0 / (1 << DB_BITS);
static const int DB_MUTE = 1 << DB_BITS;

// Dynamic range of envelope
static const double EG_STEP = 0.375;
static const int EG_BITS = 7;
static const int EG_MUTE = 1 << EG_BITS;

// Dynamic range of total level
static const double TL_STEP = 0.75;
static const int TL_BITS = 6;
static const int TL_MUTE = 1 << TL_BITS;

// Dynamic range of sustine level
static const double SL_STEP = 3.0;
static const int SL_BITS = 4;
static const int SL_MUTE = 1 << SL_BITS;

// Bits for liner value
static const int DB2LIN_AMP_BITS = 8;
static const int SLOT_AMP_BITS = DB2LIN_AMP_BITS;

// Bits for envelope phase incremental counter
static const int EG_DP_BITS = 22;
static const int EG_DP_WIDTH = 1 << EG_DP_BITS;

// Bits for Pitch and Amp modulator 
static const int PM_PG_BITS = 8;
static const int PM_PG_WIDTH = 1 << PM_PG_BITS;
static const int PM_DP_BITS = 16;
static const int PM_DP_WIDTH = 1 << PM_DP_BITS;
static const int AM_PG_BITS = 8;
static const int AM_PG_WIDTH = 1 << AM_PG_BITS;
static const int AM_DP_BITS = 16;
static const int AM_DP_WIDTH = 1 << AM_DP_BITS;

// PM table is calcurated by PM_AMP * pow(2,PM_DEPTH*sin(x)/1200) 
static const int PM_AMP_BITS = 8;
static const int PM_AMP = 1 << PM_AMP_BITS;

// PM speed(Hz) and depth(cent) 
static const double PM_SPEED = 6.4;
static const double PM_DEPTH = 13.75;

// AM speed(Hz) and depth(dB)
static const double AM_SPEED = 3.6413;
static const double AM_DEPTH = 4.875;


static const int NULL_PATCH_IDX = 19 * 2;

class OpenYM2413_2 : public OpenYM2413Base
{
    struct Patch {
        Patch();
        Patch(int n, const uint8_t* data);
        
        bool AM;
        bool PM;
        bool EG;
        uint8_t KR; // 0-1
        uint8_t ML; // 0-15
        uint8_t KL; // 0-3
        uint8_t TL; // 0-63
        uint8_t FB; // 0-7
        uint8_t WF; // 0-1
        uint8_t AR; // 0-15
        uint8_t DR; // 0-15
        uint8_t SL; // 0-15
        uint8_t RR; // 0-15
    };
    
    class Slot {
    public:
        Slot(bool type);
        void reset(bool type);

        inline void slotOn();
        inline void slotOn2();
        inline void slotOff();
        inline void setPatch(int idx);
        inline void setVolume(int volume);
        inline void calc_phase(int lfo_pm);
        inline void calc_envelope(int lfo_am);
        inline int calc_slot_car(int fm);
        inline int calc_slot_mod();
        inline int calc_slot_tom();
        inline int calc_slot_snare(bool noise);
        inline int calc_slot_cym(unsigned int pgout_hh);
        inline int calc_slot_hat(int pgout_cym, bool noise);
        inline void updatePG();
        inline void updateTLL();
        inline void updateRKS();
        inline void updateWF();
        inline void updateEG();
        inline void updateAll();
        inline static int wave2_4pi(int e);
        inline static int wave2_8pi(int e);
        inline static int EG2DB(int d);
    
        Patch* patches;
        int patchIdx;
        bool type;      // 0 : modulator 1 : carrier 
        bool slot_on_flag;

        // OUTPUT
        int feedback;
        int output[5];  // Output value of slot 

        // for Phase Generator (PG)
        word* sintbl;       // Wavetable
        int sintblIdx;
        unsigned int phase; // Phase 
        unsigned int dphase;    // Phase increment amount 
        unsigned int pgout; // output

        // for Envelope Generator (EG)
        int fnum;       // F-Number
        int block;      // Block
        int volume;     // Current volume
        int sustine;        // Sustine 1 = ON, 0 = OFF
        int tll;        // Total Level + Key scale level
        int rks;        // Key scale offset (Rks)
        int eg_mode;        // Current state
        unsigned int eg_phase;  // Phase
        unsigned int eg_dphase; // Phase increment amount
        unsigned egout;     // output
    };
    friend class Slot;
    
    class Channel {
    public:
        Channel();
        void reset();
        inline void setPatch(int num);
        inline void setSustine(bool sustine);
        inline void setVol(int volume);
        inline void setFnumber(int fnum);
        inline void setBlock(int block);
        inline void keyOn();
        inline void keyOff();

        Patch* patches;
        int patch_number;
        Slot mod, car;
    };

public:
    OpenYM2413_2(short volume);
    virtual ~OpenYM2413_2();

    virtual void reset();
    virtual void writeReg(uint8_t reg, uint8_t value);
    virtual uint8_t peekReg(uint8_t r) { return reg[r]; }

    // SoundDevice
    virtual void setInternalVolume(short newVolume);
    virtual int* updateBuffer(int *buffer, int length);
    virtual void setSampleRate(int newSampleRate, int Oversampling);
    
private:
    void calcSample(int *voice, int *drum);

    void checkMute();
    bool checkMuteHelper();

    static void makeAdjustTable();
    static void makeSinTable();
    static int lin2db(double d);
    static void makePmTable();
    static void makeAmTable();
    static void makeDphaseTable(int sampleRate);
    static void makeTllTable();
    static void makeDphaseARTable(int sampleRate);
    static void makeDphaseDRTable(int sampleRate);
    static void makeRksTable();
    static void makeDB2LinTable();
    
    inline void keyOn_BD();
    inline void keyOn_SD();
    inline void keyOn_TOM();
    inline void keyOn_HH();
    inline void keyOn_CYM();
    inline void keyOff_BD();
    inline void keyOff_SD();
    inline void keyOff_TOM();
    inline void keyOff_HH();
    inline void keyOff_CYM();
    inline void update_rhythm_mode();
    inline void update_key_status();
    inline void update_noise();
    inline void update_ampm();

    inline static int TL2EG(int d);
    inline static unsigned int DB_POS(double x);
    inline static unsigned int DB_NEG(double x);

    int filter(int id, int input);
private:
    int maxVolume;

    // Register
    uint8_t reg[0x40];

    // Pitch Modulator
    unsigned int pm_phase;
    int lfo_pm;

    // Amp Modulator
    unsigned int am_phase;
    int lfo_am;

    // Noise Generator
    int noise_seed;

    // Filter
    int filter_values[2][5];

    // CHECK check with orig code header file line 98-104
    
    // Channel & Slot
    Channel ch[9];

    // Voice Data
    Patch patches[19 * 2 + 1];

    // Noise and LFO
    static unsigned int pm_dphase;
    static unsigned int am_dphase;

    // Definition of envelope mode
    enum { READY, ATTACK, DECAY, SUSHOLD, SUSTINE, RELEASE, SETTLE, FINISH };

    // Tables generated at creation, will be allocated in PSRAM
    struct tables_t {
        // dB to linear table (used by Slot)
        short dB2LinTab[(DB_MUTE + DB_MUTE) * 2];

        // WaveTable for each envelope amp
        word fullsintable[PG_WIDTH];
        word halfsintable[PG_WIDTH];
        word* waveform[2];

        unsigned int dphaseNoiseTable[512][8];

        // LFO Table
        int pmtable[PM_PG_WIDTH];
        int amtable[AM_PG_WIDTH];

        // Liner to Log curve conversion table (for Attack rate).
        word AR_ADJUST_TABLE[1 << EG_BITS];

        // Phase incr table for Attack
        unsigned int dphaseARTable[16][16];
        // Phase incr table for Decay and Release
        unsigned int dphaseDRTable[16][16];

        // KSL + TL Table
        unsigned int tllTable[16][8][1 << TL_BITS][4];
        int rksTable[2][8][2];

        // Phase incr table for PG 
        unsigned int dphaseTable[512][8][16];
    };
    static tables_t *tables;
};

#endif
