timembedded/hyper-fusion-xc/firmware/esp32s3/main/bluemsx/OpenMsxY8950Adpcm.cpp

// $Id: OpenMsxY8950Adpcm.cpp,v 1.5 2007/08/05 21:14:39 dvik Exp $

#include <string.h>
#include <freertos/FreeRTOS.h>

#include "OpenMsxY8950Adpcm.h"
#include "OpenMsxY8950.h"

#include "esp_heap_caps.h"

// Relative volume between ADPCM part and FM part, 
// value experimentally found by Manuel Bilderbeek
const int ADPCM_VOLUME = 356;

// Bitmask for register 0x07
static const int R07_RESET        = 0x01;
//static const int R07            = 0x02;.      // not used
//static const int R07            = 0x04;.      // not used
const int R07_SP_OFF       = 0x08;
const int R07_REPEAT       = 0x10;
const int R07_MEMORY_DATA  = 0x20;
const int R07_REC          = 0x40;
const int R07_START        = 0x80;

//Bitmask for register 0x08
const int R08_ROM          = 0x01;
const int R08_64K          = 0x02;
const int R08_DA_AD        = 0x04;
const int R08_SAMPL        = 0x08;
//const int R08            = 0x10;.      // not used
//const int R08            = 0x20;.      // not used
const int R08_NOTE_SET     = 0x40;
const int R08_CSM          = 0x80;

const int DMAX = 0x6000;
const int DMIN = 0x7F;
const int DDEF = 0x7F;

const int DECODE_MAX = 32767;
const int DECODE_MIN = -32768;

const int GETA_BITS  = 14;
const unsigned int MAX_STEP   = 1<<(16+GETA_BITS);


//**************************************************//
//                                                  //
//  Helper functions                                //
//                                                  //
//**************************************************//

int Y8950Adpcm::CLAP(int min, int x, int max)
{
    return (x < min) ? min : ((max < x) ? max : x);
}

//**********************************************************//
//                                                          //
//  Y8950Adpcm                                              //
//                                                          //
//**********************************************************//

Y8950Adpcm::Y8950Adpcm(Y8950& y8950_, int sampleRam)
    : y8950(y8950_), ramSize(sampleRam), volume(0)
{
    ramBank = (uint8_t*)heap_caps_malloc(ramSize, MALLOC_CAP_SPIRAM);
    memset(ramBank, 0xFF, ramSize);
    fifo_init(&adpcmFifo, fifoBuffer, sizeof(fifoBuffer));
    unschedule();
}

Y8950Adpcm::~Y8950Adpcm()
{
    heap_caps_free(ramBank);
}

void Y8950Adpcm::reset()
{
    playing = false;
    startAddr = 0;
    stopAddr = 7;
    memPntr = 0;
    delta = 0;
    step = 0;
    addrMask = (1 << 19) - 1;
    reg7 = 0;
    reg15 = 0;
    writeReg(0x12, 255);  // volume
    restart();
}

void Y8950Adpcm::setSampleRate(int sr)
{
    sampleRate = sr;
}

bool Y8950Adpcm::muted()
{
    return (!playing) || (reg7 & R07_SP_OFF);
}

//**************************************************//
//                                                  //
//                       I/O Ctrl                   //
//                                                  //
//**************************************************//

void Y8950Adpcm::restart()
{
    playAddr = startAddr & addrMask;
    nowStep = MAX_STEP - step;
    out = output = 0;
    diff = DDEF;
    nextLeveling = 0;
    sampleStep = 0;
    volumeWStep = (int)((double)volume * step / MAX_STEP);
}

void Y8950Adpcm::schedule()
{
}

void Y8950Adpcm::unschedule()
{
}

void Y8950Adpcm::writeReg(uint8_t rg, uint8_t data)
{
    //PRT_DEBUG("Y8950Adpcm: write "<<(int)rg<<" "<<(int)data);
    switch (rg) {
        case 0x07: // START/REC/MEM DATA/REPEAT/SP-OFF/-/-/RESET
            reg7 = data;
            Y8950Log(Y8950LogLevel_Info, "reg7=%x\n", reg7);
            if (reg7 & R07_RESET) {
                Y8950Log(Y8950LogLevel_Info, "Stop\n");
                playing = false;
            } else if (data & R07_START) {
                Y8950Log(Y8950LogLevel_Info, "Start\n");
                playing = true;
                restart();
            }
            
            if (playing) {
                schedule();
            } else {
                unschedule();
//              Scheduler::instance().removeSyncPoint(this);
            }
            break;

        case 0x08: // CSM/KEY BOARD SPLIT/-/-/SAMPLE/DA AD/64K/ROM 
            romBank = data & R08_ROM;
            addrMask = data & R08_64K ? (1<<17)-1 : (1<<19)-1;
            break;

        case 0x09: // START ADDRESS (L)
            Y8950Log(Y8950LogLevel_Info, "START ADDRESS (L) = %x\n", data);
            startAddr = (startAddr & 0x7F800) | (data << 3);
            memPntr = 0;
            break;
        case 0x0A: // START ADDRESS (H) 
            Y8950Log(Y8950LogLevel_Info, "START ADDRESS (H) = %x\n", data);
            startAddr = (startAddr & 0x007F8) | (data << 11);
            memPntr = 0;
            break;

        case 0x0B: // STOP ADDRESS (L)
            Y8950Log(Y8950LogLevel_Info, "STOP ADDRESS (L) = %x\n", data);
            stopAddr = (stopAddr & 0x7F807) | (data << 3);
            break;
        case 0x0C: // STOP ADDRESS (H) 
            Y8950Log(Y8950LogLevel_Info, "STOP ADDRESS (H) = %x\n", data);
            stopAddr = (stopAddr & 0x007FF) | (data << 11);
            break;


        case 0x0F: // ADPCM-DATA
            // TODO check this
            if ((reg7 & 0xE0) == 0x60) {
                // Write to memory from CPU
                int tmp = ((startAddr + memPntr) & addrMask) / 2;
                tmp = (tmp < ramSize) ? tmp : (tmp & (ramSize - 1)); 
                if (!romBank) {
                    ramBank[tmp] = data;
                    Y8950Log(Y8950LogLevel_Debug, "mem[%x] = %x\n", tmp, data);
                }
                memPntr += 2;
            }
            if ((reg7 & 0xE0) == 0x80) {
                // ADPCM synthesis from CPU
                while (!fifo_push(&adpcmFifo, &data, 1)) {
                    // TODO: This constantly happens, needs investigation
                    Y8950Log(Y8950LogLevel_Debug, "full\n");
                    vTaskDelay(1);
                }
            }
            break;

        case 0x10: // DELTA-N (L) 
            delta = (delta & 0xFF00) | data;
            step = Y8950::rate_adjust(delta<<GETA_BITS, sampleRate);
            volumeWStep = (int)((double)volume * step / MAX_STEP);
            break;
        case 0x11: // DELTA-N (H) 
            delta = (delta & 0x00FF) | (data << 8);
            step = Y8950::rate_adjust(delta<<GETA_BITS, sampleRate);
            volumeWStep = (int)((double)volume * step / MAX_STEP);
            break;

        case 0x12: { // ENVELOP CONTROL 
            int oldVol = volume;
            volume = (data * ADPCM_VOLUME) >> 8;
            if (oldVol != 0) {
                double factor = (double)volume / (double)oldVol;
                output =     (int)((double)output     * factor);
                sampleStep = (int)((double)sampleStep * factor);
            }
            volumeWStep = (int)((double)volume * step / MAX_STEP);
            break;
        }
        case 0x0D: // PRESCALE (L)
            Y8950Log(Y8950LogLevel_Info, "PRESCALE L = %x\n", data);
            break;
        case 0x0E: // PRESCALE (H) 
            Y8950Log(Y8950LogLevel_Info, "PRESCALE H = %x\n", data);
            break;
        case 0x15: // DAC-DATA  (bit9-2)
        case 0x16: //           (bit1-0)
        case 0x17: //           (exponent)
        case 0x1A: // PCM-DATA
            // not implemented
            break;
    }
}

uint8_t Y8950Adpcm::readReg(uint8_t rg)
{
    uint8_t result;
    switch (rg) {
        case 0x0F: { // ADPCM-DATA
            // TODO don't advance pointer when playing???
            int adr = ((startAddr + memPntr) & addrMask) / 2;
            if (romBank || (adr >= ramSize)) {
                result = 0xFF;
            } else {
                result = ramBank[adr];
            }
            memPntr += 2;
            break;
        }
        case 0x13: // TODO check
            result = out & 0xFF;
            break;
        case 0x14: // TODO check
            result = out / 256;
            break;
        default:
            result = 255;
    }
    //PRT_DEBUG("Y8950Adpcm: read "<<(int)rg<<" "<<(int)result);
    return result;
}

int Y8950Adpcm::calcSample()
{
    // This table values are from ymdelta.c by Tatsuyuki Satoh.
    static const int F1[16] = { 1,   3,   5,   7,   9,  11,  13,  15,
                   -1,  -3,  -5,  -7,  -9, -11, -13, -15};
    static const int F2[16] = {57,  57,  57,  57,  77, 102, 128, 153,
                   57,  57,  57,  57,  77, 102, 128, 153};
    
    if (muted()) {
        return 0;
    }
    nowStep += step;
    if (nowStep >= MAX_STEP) {
        int nowLeveling = nextLeveling;
        do {
            nowStep -= MAX_STEP;
            unsigned long val;
            if ((reg7 & R07_MEMORY_DATA)==0) {
                // ADPCM synthesis from FIFO
                if (!(playAddr & 1)) {
                    if (!fifo_pop_byte(&adpcmFifo, &reg15)) {
                        Y8950Log(Y8950LogLevel_Debug, "empty\n");
                        // do again later
                        return output >> 12;
                    }
                    val = reg15 >> 4;
                } else {
                    val = reg15 & 0x0F;
                }
            } else {
                // ADPCM synthesis from memory
                if (!(playAddr & 1)) {
                    // n-th nibble
                    int tmp = playAddr / 2;
                    if (romBank || (tmp >= ramSize)) {
                        reg15 = 0xFF;
                    } else {
                        reg15 = ramBank[tmp];
                    }
                    val = reg15 >> 4;
                } else {
                    // (n+1)-th nibble
                    val = reg15 & 0x0F;
                }
            }
            int prevOut = out;
            out = CLAP(DECODE_MIN, out + (diff * F1[val]) / 8,
                       DECODE_MAX);
            diff = CLAP(DMIN, (diff * F2[val]) / 64, DMAX);
            int deltaNext = out - prevOut;
            nowLeveling = nextLeveling;
            nextLeveling = prevOut + deltaNext / 2;
        
            playAddr++;
            if ((reg7 & R07_MEMORY_DATA) && playAddr > stopAddr) {
                if (reg7 & R07_REPEAT) {
                    Y8950Log(Y8950LogLevel_Info, "Restart\n");
                    restart();
                } else {
                    playing = false;
                    //y8950.setStatus(Y8950::STATUS_EOS);
                }
            }
        } while (nowStep >= MAX_STEP);
        sampleStep = (nextLeveling - nowLeveling) * volumeWStep;
        output = nowLeveling * volume;
        output += (int)((double)sampleStep * ((double)nowStep/(double)step));
    }
    output += sampleStep;
    return output >> 12;
}
