timembedded/hyper-fusion-xc/firmware/proto/hdl/mega_ram.vhd

------------------------------------------------------------------------
-- Copyright (C) 2024 Tim Brugman
--
--  This firmware is free code: you can redistribute it and/or modify
--  it under the terms of the GNU General Public License as published
--  by the Free Software Foundation, version 3
--
--  This firmware is distributed in the hope that it will be useful,
--  but WITHOUT ANY WARRANTY; without even the implied warranty of
--  MERCHANTABILITY or FITNESS FOR A PARTICULAR PURPOSE
--  See the GNU General Public License for more details
--
--  You should have received a copy of the GNU General Public License
--  along with this program. If not, see https://www.gnu.org/licenses/
--
------------------------------------------------------------------------
-- Mega-RAM mapper
------------------------------------------------------------------------
library ieee;
use ieee.std_logic_1164.all;
use ieee.numeric_std.all;

entity mega_ram is
  port(
    -- clock and reset
    clock                  : in std_logic;
    slot_reset             : in std_logic;
    soft_reset             : in std_logic;

    -- EEPROM
    EECS                   : out std_logic;
    EECK                   : out std_logic;
    EEDI                   : out std_logic;
    EEDO                   : in std_logic;

    -- Config
    enable_expand          : out std_logic;
    enable_sd              : out std_logic;
    enable_mapper          : out std_logic;
    enable_fmpac           : out std_logic;
    enable_scc             : out std_logic;

    -- Misc
    our_slot               : in std_logic_vector(1 downto 0);
    enable_shadow_ram      : out std_logic;

    -- SCC mode registers
    EseScc_MA19            : in std_logic;
    EseScc_MA20            : in std_logic;
    SccPlus_Enable         : in std_logic;
    SccPlus_AllRam         : in std_logic;
    SccPlus_B0Ram          : in std_logic;
    SccPlus_B1Ram          : in std_logic;
    SccPlus_B2Ram          : in std_logic;

    -- avalon slave port
    mes_mega_read          : in std_logic;
    mes_mega_write         : in std_logic;
    mes_mega_address       : in std_logic_vector(15 downto 0);
    mes_mega_writedata     : in std_logic_vector(7 downto 0);
    mes_mega_readdata      : out std_logic_vector(7 downto 0);
    mes_mega_readdatavalid : out std_logic;
    mes_mega_waitrequest   : out std_logic;
    -- 0xf0
    ios_mega_read          : in std_logic;
    ios_mega_write         : in std_logic;
    ios_mega_address       : in std_logic_vector(1 downto 0);
    ios_mega_writedata     : in std_logic_vector(7 downto 0);
    ios_mega_readdata      : out std_logic_vector(7 downto 0);
    ios_mega_readdatavalid : out std_logic;
    ios_mega_waitrequest   : out std_logic;

    -- avalon master port
    mem_mega_read          : out std_logic;
    mem_mega_write         : out std_logic;
    mem_mega_address       : out std_logic_vector(23 downto 0);
    mem_mega_writedata     : out std_logic_vector(7 downto 0);
    mem_mega_readdata      : in std_logic_vector(7 downto 0);
    mem_mega_readdatavalid : in std_logic;
    mem_mega_waitrequest   : in std_logic
  );
end mega_ram;

architecture rtl of mega_ram is

  signal EECS1                      : std_logic;
  signal EECK1                      : std_logic;
  signal EEDI1                      : std_logic;

  type map_bank_t is record
    Mask     : std_logic_vector(7 downto 0);
    Addr     : std_logic_vector(7 downto 0);
    Reg      : std_logic_vector(7 downto 0);
    Mult     : std_logic_vector(7 downto 0);
    MaskR    : std_logic_vector(7 downto 0);
    AdrD     : std_logic_vector(7 downto 0);
  end record;

  signal aMconf                     : std_logic_vector(7 downto 0);
  signal Mconf                      : std_logic_vector(7 downto 0);
  signal DecMDR                     : std_logic;
  signal RloadEn                    : std_logic;
  signal NSC, NSC_SCCP              : std_logic; -- Non standard
  signal PF0_RV                     : std_logic_vector(1 downto 0);
  signal PFXN                       : std_logic_vector(1 downto 0):= "00";

  signal CardMDR                    : std_logic_vector(7 downto 0);
  signal AddrM0                     : std_logic_vector(7 downto 0);
  signal AddrM1                     : std_logic_vector(7 downto 0);
  signal AddrM2                     : std_logic_vector(6 downto 0);
  signal AddrFR                     : std_logic_vector(6 downto 0);

  signal R1                         : map_bank_t;
  signal R2                         : map_bank_t;
  signal R3                         : map_bank_t;
  signal R4                         : map_bank_t;

  type page_size_t is (PAGE_64k, PAGE_32k, PAGE_16k, PAGE_8k, PAGE_NONE);
  signal MR1A_c1_i, MR1A_c1_r       : page_size_t;
  signal MR2A_c1_i, MR2A_c1_r       : page_size_t;
  signal MR3A_c1_i, MR3A_c1_r       : page_size_t;
  signal MR4A_c1_i, MR4A_c1_r       : page_size_t;

  signal card_seq_r                 : integer range 0 to 3;
  signal card_det_r                 : std_logic;
  signal card_info_x, card_info_r   : std_logic_vector(23 downto 0);
  signal card_info_latch_r          : std_logic;

  signal ios_mega_readdata_i        : std_logic_vector(7 downto 0);

  signal mes_mega_reg_addr_i        : std_logic_vector(5 downto 0);
  signal mes_mega_reg_addr_r        : std_logic_vector(5 downto 0);
  signal mes_mega_reg_readdata_x    : std_logic_vector(7 downto 0);
  signal mes_mega_reg_readdata_r    : std_logic_vector(7 downto 0);

  signal mem_mega_read_c1_i         : std_logic;
  signal mem_mega_write_c1_i        : std_logic;

  signal mem_mega_read_c1_r         : std_logic;
  signal mem_mega_write_c1_r        : std_logic;
  signal mem_mega_address_c1_r      : std_logic_vector(15 downto 0);
  signal mem_mega_writedata_c1_r    : std_logic_vector(7 downto 0);
  signal mem_mega_page_i            : std_logic_vector(10 downto 0);
  signal mem_mega_use_ram_i         : std_logic;

  signal mem_mega_read_c2_i         : std_logic;
  signal mem_mega_rdff_c2_i         : std_logic;
  signal mem_mega_read_c2_r         : std_logic;
  signal mem_mega_rdff_c2_r         : std_logic;
  signal mem_mega_write_c2_i        : std_logic;
  signal mem_mega_write_c2_r        : std_logic;
  signal mem_mega_address_c2_r      : std_logic_vector(15 downto 0);
  signal mem_mega_writedata_c2_r    : std_logic_vector(7 downto 0);
  signal mem_mega_page_c2_r         : std_logic_vector(10 downto 0);
  signal mem_mega_use_ram_c2_r      : std_logic;

  signal mem_mega_map_i                               : std_logic_vector(10 downto 0);
  signal mem_mega_address_i                           : std_logic_vector(23 downto 0);
  signal mem_mega_read_r, mem_mega_read_x             : std_logic;
  signal mem_mega_write_r, mem_mega_write_x           : std_logic;
  signal mem_mega_address_r, mem_mega_address_x       : std_logic_vector(23 downto 0);
  signal mem_mega_writedata_r, mem_mega_writedata_x   : std_logic_vector(7 downto 0);

  signal mem_memreg_write_r, mem_memreg_write_x         : std_logic;
  signal mem_memreg_writedata_r, mem_memreg_writedata_x : std_logic_vector(7 downto 0);

  signal mem_ioreg_write_r, mem_ioreg_write_x         : std_logic;
  signal mem_ioreg_writedata_r, mem_ioreg_writedata_x : std_logic_vector(7 downto 0);
  signal mem_ioreg_address_r, mem_ioreg_address_x     : std_logic_vector(1 downto 0);

  signal mem_nonreg_write_r, mem_nonreg_write_x       : std_logic;
  signal mem_nonreg_writedata_r, mem_nonreg_writedata_x : std_logic_vector(7 downto 0);
  signal mem_nonreg_address_r, mem_nonreg_address_x   : std_logic_vector(15 downto 0);

  signal mes_mega_readdata_r, mes_mega_readdata_x     : std_logic_vector(7 downto 0);
  signal mes_mega_readdatavalid_r, mes_mega_readdatavalid_x : std_logic;
  type mes_read_state_t is (MR_IDLE, MR_REG, MR_CARD, MR_MEM);
  signal mes_read_state_r, mes_read_state_x           : mes_read_state_t;

begin

  -- Config register documentation
  -- -----------------------------
  --
  -- CardMDR
  --   bit 7    - disable is conf.regs;
  --   bit 6..5 - addr r.conf=0F80/4F80/8F80/CF80
  --   bit 4    - enable SCC,
  --   bit 3    - delayed reconfiguration (bank registers only)
  --   bit 2    - select activate bank configurations 0=of start/jmp0/rst0 1= read(400Xh)
  --   bit 1    - Shadow BIOS ( to RAM )
  --   bit 0    - Disable read direct card vector port and card configuration register (4F80..)
  --
  -- Mconf
  --   bit 7    - enable Expand Slot
  --   bit 6    - enable Read mapper port ( FC FD FE FF )
  --   bit 5    - enable YM2413 (FM Pack syntesator)
  --   bit 4    - enable control MMM port (3C)
  --   bit 3    - enable x3 Expand slot FM Pack BIOS ROM
  --   bit 2    - enable x2 Expand slot MMM RAM mapper
  --   bit 1    - enable x1 Expand slot CF card disk interface
  --   bit 0    - enable x0 Expand slot SCC Cartridge
  --
  -- Rx.Mult
  --   bit 7    - enable page register bank 1
  --   bit 6    -
  --   bit 5    - RAM (select RAM or atlernative ROM...)
  --   bit 4    - enable write to bank
  --   bit 3    - disable bank ( read and write )
  --   bit 2..0 - bank size
  --              111 - 64kbyte
  --              110 - 32
  --              101 - 16
  --              100 - 8
  --              011 - 4
  --              other - disable bank

  -- Config output
  enable_expand <= Mconf(7);
  enable_scc <= Mconf(0) and CardMDR(4);
  enable_sd <= Mconf(1);
  enable_mapper <= Mconf(2);
  enable_fmpac <= Mconf(3);

  -- EEPROM Output
  EECS <= '1' when EECS1 = '1' else '0';
  EECK <= '1' when EECK1 = '1' else '0';
  EEDI <= '1' when EEDI1 = '1' else '0';

  enable_shadow_ram  <= CardMDR(1);

  mem_mega_read      <= mem_mega_read_r;
  mem_mega_write     <= mem_mega_write_r;
  mem_mega_address   <= mem_mega_address_r;
  mem_mega_writedata <= mem_mega_writedata_r;


  ----------------------------------------------------------
  -- I/O port register read (0xF0)
  ----------------------------------------------------------

  ios_mega_readdata_i <= 
      "00110010"  when (ios_mega_address = PFXN and PF0_RV = "01") else    -- char "2"
      "001100"& our_slot
                  when (ios_mega_address = PFXN and PF0_RV(1) = '1') else  -- char "2"
      x"ff";

  ios_mega_readdata <= ios_mega_readdata_i when rising_edge(clock);
  ios_mega_readdatavalid <= ios_mega_read when rising_edge(clock);
  ios_mega_waitrequest <= '0';


  ----------------------------------------------------------
  -- Memory-mapped register read
  ----------------------------------------------------------

  mes_mega_reg_addr_i <= mes_mega_address(5 downto 0);

  mes_mega_reg_readdata_x <=
      CardMDR     when mes_mega_reg_addr_i = "000000" else
      AddrM0      when mes_mega_reg_addr_i = "000001" else
      AddrM1      when mes_mega_reg_addr_i = "000010" else
      "0"&AddrM2  when mes_mega_reg_addr_i = "000011" else
      "0"&AddrFR  when mes_mega_reg_addr_i = "000101" else

      R1.Mask     when mes_mega_reg_addr_i = "000110" else
      R1.Addr     when mes_mega_reg_addr_i = "000111" else
      R1.Reg      when mes_mega_reg_addr_i = "001000" else
      R1.Mult     when mes_mega_reg_addr_i = "001001" else
      R1.MaskR    when mes_mega_reg_addr_i = "001010" else
      R1.AdrD     when mes_mega_reg_addr_i = "001011" else

      R2.Mask     when mes_mega_reg_addr_i = "001100" else
      R2.Addr     when mes_mega_reg_addr_i = "001101" else
      R2.Reg      when mes_mega_reg_addr_i = "001110" else
      R2.Mult     when mes_mega_reg_addr_i = "001111" else
      R2.MaskR    when mes_mega_reg_addr_i = "010000" else
      R2.AdrD     when mes_mega_reg_addr_i = "010001" else

      R3.Mask     when mes_mega_reg_addr_i = "010010" else
      R3.Addr     when mes_mega_reg_addr_i = "010011" else
      R3.Reg      when mes_mega_reg_addr_i = "010100" else
      R3.Mult     when mes_mega_reg_addr_i = "010101" else
      R3.MaskR    when mes_mega_reg_addr_i = "010110" else
      R3.AdrD     when mes_mega_reg_addr_i = "010111" else

      R4.Mask     when mes_mega_reg_addr_i = "011000" else
      R4.Addr     when mes_mega_reg_addr_i = "011001" else
      R4.Reg      when mes_mega_reg_addr_i = "011010" else
      R4.Mult     when mes_mega_reg_addr_i = "011011" else
      R4.MaskR    when mes_mega_reg_addr_i = "011100" else
      R4.AdrD     when mes_mega_reg_addr_i = "011101" else

      Mconf       when mes_mega_reg_addr_i = "011110" else
      CardMDR     when mes_mega_reg_addr_i = "011111" else

      "0000" & EECS1 & EECK1 & EEDI1 & EEDO 
                  when mes_mega_reg_addr_i = "100011" else

      "111100" & PFXN 
                  when mes_mega_reg_addr_i = "110101" else
      (others => '0');

  mes_mega_readdatavalid <= mes_mega_readdatavalid_r;
  mes_mega_readdata <= mes_mega_readdata_r;

  process(all)
  begin
    card_info_x <= card_info_r;
    mes_read_state_x <= mes_read_state_r;
    mes_mega_readdata_x <= (others => '-');
    mes_mega_readdatavalid_x <= '0';
    mes_mega_waitrequest <= '1';
    mem_mega_read_c1_i <= '0';

    if (card_info_latch_r = '1') then
      card_info_x <= x"435632";
    end if;

    case (mes_read_state_r) is
      when MR_IDLE =>
        -- Accept transfers when not busy writing
        mes_mega_waitrequest <= mem_mega_write_c1_r or mem_mega_write_c2_r or mem_mega_write_r;
        -- Handle read requests
        if (mes_mega_read = '1') then
          if (DecMDR = '1' and CardMDR(0) = '0' and
              mes_mega_address(5 downto 0) /= "000100" -- DatM0
              ) then 
            -- Read registers
            mes_read_state_x <= MR_REG;
          elsif (card_det_r = '1' and mes_mega_address = x"4000") then
            -- Read card detect register
            mes_read_state_x <= MR_CARD;
          else
            -- Read from mapped ram/flash
            mem_mega_read_c1_i <= '1';
            mes_read_state_x <= MR_MEM;
          end if;
        end if;

      when MR_REG =>
        -- Read register data
        mes_mega_readdata_x <= mes_mega_reg_readdata_r;
        mes_mega_readdatavalid_x <= '1';
        mes_read_state_x <= MR_IDLE;

      when MR_CARD =>
        -- Read card detect register
        mes_mega_readdata_x <= card_info_r(card_info_r'high downto card_info_r'high - 7);
        card_info_x <= card_info_r(card_info_r'high - 8 downto 0) & x"00";
        mes_mega_readdatavalid_x <= '1';
        mes_read_state_x <= MR_IDLE;

      when MR_MEM =>
        -- Read memory, wait till data is returned
        if (mem_mega_rdff_c2_r = '1') then
          -- Bank disabled, return 0xff
          mes_mega_readdata_x <= x"ff";
          mes_mega_readdatavalid_x <= '1';
          mes_read_state_x <= MR_IDLE;
        elsif (mem_mega_readdatavalid = '1') then
          mes_mega_readdata_x <= mem_mega_readdata;
          mes_mega_readdatavalid_x <= '1';
          mes_read_state_x <= MR_IDLE;
        end if;
    end case;
  end process;


  ----------------------------------------------------------
  -- Memory-mapped and I/O register write
  ----------------------------------------------------------

  DecMDR <= '1' when mes_mega_address(13 downto 6) = "00111110" and
                     CardMDR(7) = '0' and mes_mega_address(15 downto 14) = CardMDR(6 downto 5) else '0';
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
