timembedded/hyper-fusion-xc/(commit log)

2025-03-14 Work in progress schematic and PCB
    [HyperFusionXC.FCStd, HyperFusionXC.kicad_pcb, HyperFusionXC.kicad_sch, HyperFusionXC.pcb, HyperFusionXC.sch]
2025-03-17 Work in progress
    [HyperFusionXC.kicad_pcb, HyperFusionXC.kicad_sch]
2025-12-17 Integrated Moonsound and optimized memory usage for buffers Moonsound not working yet because of performance issues
    [partitions.csv]
2025-12-30 Sample transition on zero crossing to prevent clicking sound
    [AudioMixer.h, OpenMsxYMF278.cpp, OpenMsxYMF278.h, audiodev.c, fpga.c]
2025-12-30 Improved load reporting and reset
    [audiodev.c]
2026-01-01 Automatic mono/stereo switching for music+audio
2026-01-26 Tighter slot timing for Turbo-R compatibility
    [card_slave.vhd]
2026-02-02 Schematic work in progress
    [HyperFusionXC.kicad_pcb, HyperFusionXC.kicad_sch, NAU88C22YG.step, UJ20-C-H-G-SMT-2-P16-TR.step]
2026-02-20 PCB work in progress
    [DLM0NSN900HY2D.step, HyperFusionXC.kicad_pcb, HyperFusionXC.kicad_sch]
2026-03-26 Routing done
    [AP7366EA-18W5-7.stp, HyperFusionXC.kicad_pcb, HyperFusionXC.kicad_sch]
2026-04-17 Redesigned HDMI to solve obsolescence
    [HyperFusionXC.kicad_pcb, HyperFusionXC.kicad_sch, WQFN-30-2.5x4.5-p0.4.step]
