timembedded/hyper-fusion-xc/(notices)

Notices in the files:
board/HyperFusionXC.sch:
(copyright "Copyright © 1992-2006 Altium Limited")
